verbkinm/IOT/IOTV/docs/Описание протокола IOTV.odt

IOTV протокол, версия 2

# Заголовок протокола

Размер: 24 байта + N байт, N максимум 2⁶⁴ - 1

Версия протокола | Тип пакета | Назначение пакета | Флаги | Номер фрагмента | Количество фрагментов | Размер тела пакета | Контрольная сумма заголовка
1 байт | 1 байт | 1 байт | 1 байта | 2 байта | 2 байта | 8 байт | 8 байт
Тело протокола
(Размер тела пакета) байт

### Версия протокола

Название | Значение
Версия N | N

### Тип пакета

Название | Значение
Отсутствует | 0x00
Запрос | 0x01
Ответ | 0x02

### Назначение пакета

Название | Значение | Должно быть тело протокола
| | Запрос | Ответ
Отсутствует | 0x00 | Нет | Нет
Идентификация устройства | 0x01 | Нет | Да/Нет
Состояние устройства | 0x02 | Да | Да
Чтение данных | 0x03 | Да | Да
Запись данных | 0x04 | Да | Да
Ping/Pong | 0x05 | Нет | Нет
Технические данные | 0x06 | Да | Да
Широковещательное оповещение | 0x07 | Да | Да
Данне лог файла | 0x08 | Да | Да

### Флаги

Название | Значение
Отсутствуют | 0x00
Ошибка | 0xFF

### Размер тела пакета

Количество байт, которое ожидается после заголовка протокола.

### Контрольная сумма заголовка

Необходима для таких способов передачи как UART и пр.

Формула расчёта = Версия протокола + Тип пакета + Назначение пакета + Флаги + Номер фрагмента + Количество фрагментов + Размер тела пакета.

# Тело протокола:

Далее цветом выделена часть пакета, которая может быть фрагментирована.

## Идентификация устройства

Размер: 16 + N байт, N максимум 2⁸ - 1 + 2¹⁶ - 1 + 2⁸ - 1 + 2⁸ - 1 (16 + 66300)

ID устройства | Длина имени устройства | Количество каналов записи | | Количество каналов чтения | Длина описания устройства | | Флаги | Контрольная сумма тела пакета
2 байта | 1 байт | 1 байта | | 1 байт | 2 байта | | 1 байт | 8 байт
Имя устройства
(Длина имени устройства) байт
Тип данных канала записи № N | | | Тип данных канала чтения № N | | | Описание устройства
(Количество каналов записи) байт | | | (Количество каналов чтения) байт | | | (Длина описания устройства) байт

### ID устройства

Список описания устройств по их ID, смотри в файл Список устройств

### Количество каналов

Минимальное значение — 0. Максимальное значение — 255.

### Флаги

Название | Значение
Отсутствуют | 0x00
Удалить устройство | 0x01
Автономное устройство | 0x02
Ошибка | 0xFF

### Контрольная сумма тела пакета

Формула расчета = ID устройства + Длина имени устройства + Длина описания устройства + Количество каналов записи + Количество каналов чтения + Флаги

### Тип данных канала

Типы данных канала описываются размером в один байт. Описание типов каналов смотри в Приложение 1

## Состояние устройства

Размер: 15 + N байт, N максимум 2⁸ - 1 + 2³² - 1 (15 + 255 + 4096 Мб)

Длина имени устройства | Состояние устройства | Флаги | | Размер пакета данных | Контрольная сумма тела пакета
1 байт | 1 байт | 1 байта | | 4 байта | 8 байт
Имя устройства | | | Данные
(Длина имени устройства) байт | | | (Размер пакета данных) байт

На данный момент данные в пакете состояния устройства не задействованы в коде протокола.

### Состояние устройства

Название | Значение
Не доступно | 0x00
Доступно | 0x01

### Флаги

Название | Значение
Отсутствуют | 0x00
Ошибка | 0xFF

### Контрольная сумма тела пакета

### Формула расчёта = Длина имени устройства + Состояние устройства + Флаги + Размер пакета данных

## Чтение / Запись данных

Размер: 15 + N байт, N максимум 2⁸ - 1 + 2³² - 1 (15 + 255 + 4096 Мб)

Длина имени устройства | Номер канала | Флаги | | Размер пакета данных | Контрольная сумма тела пакета
1 байт | 1 байт | 1 байта | | 4 байта | 8 байт
Имя устройства | | | Данные
(Длина имени устройства) байт | | | (Размер пакета данных) байт

### Номер канала

Название | Значение
0 - 255 | 0x00 - 0xFF

### Флаги

Название | Значение
Отсутствуют | 0x00
Игнорировать номер канала (все каналы) | 0x01
Открыть поток | 0x02
Закрыть поток | 0x03
Запись произведена успешно | 0x04
Запись не произведена | 0x05
Ошибка | 0xFF

### Контрольная сумма тела пакета

### Формула расчёта = Длина имени устройства + Номер канала + Флаги + Размер пакета данных

## Технические данные

Размер: 15 + N байт, N максимум 2³² - 1 (15 + 4096 Мб)

Тип | Резерв | Флаги | Размер пакета данных | Контрольная сумма тела пакета
1 байт | 1 байт | 1 байта | 4 байта | 8 байт
Данные
(Размер пакета данных) байт

### Тип

Название | Значение
Отсутствует | 0x00
Передача структуры Событие - Действие (json) (приложение 2) | 0x01
Данные для обновления (json) (приложение 3) | 0x02
Запуск события (json) | 0x03
Запуск действия (json) | 0x04

### Флаги

Название | Значение
Отсутствуют | 0x00
Ошибка | 0xFF

### Контрольная сумма тела пакета

### Формула расчёта = Тип + ~~Резерв~~ + Флаги + Размер пакета данных

## Хост - широковещательное оповещение

Размер: 16 + N байт, N максимум 2⁸ - 1 (16 + 255)

Длина имени устройства | ip4 адрес | Флаги | Порт | Контрольная сумма тела пакета
1 байт | 4 байт | 1 байта | 2 байта | 8 байт
Имя устройства
(Длина имени устройства) байт

### Флаги

Название | Значение
Отсутствуют | 0x00
Клиент использует TCP соединение | 0x01
Клиент использует UDP соединение | 0x02
Ошибка | 0xFF

### Контрольная сумма тела пакета

### Формула расчёта = Длина имени устройства + ip4 адрес + Флаги + Порт

## Данные лог файла хоста

Размер: 35 + N байт, N максимум 2⁸ - 1 + 2³² - 1 (35 + 255 + 4096 Мб)

Для запроса от клиента серверу и для передачи от сервера обработанных данных по фильтрам к клиенту.

Длина имени устройства | Дата/время начала интервала (миллисекунды) | Дата/время конца интервала (миллисекунды) | Интервал между записями (миллисекунды) | Флаги | Номер канала | Размер фрагмента данных
1 байт | 8 байт | 8 байт | 4 байта | 1 байта | 1 байта | 4 байта
Контрольная сумма пакета | | Имя устройства | | Данные
8 байт | | (Длина имени устройства) байт | | (Размер пакета данных) байт

### Флаги

Название | Значение
Для записей R и W в лог файле | 0x00
Для записей R в лог файле | 0x01
Для записей W в лог файле | 0x02
Ошибка | 0xFF

### Контрольная сумма тела пакета

### Формула расчёта = Длина имени устройства + Дата/время начала интервала + Дата/время конца интервала + Флаги + Номер канала + Размер пакета данных.

Структура фрагмента Данные состоит из текстовых строк формата

std::to_string(ms) + " " + valueStr + "\n";

# Приложение 1

### Типы данных каналов

# enum DATA_TYPE

{

INT_8,

INT_16,

INT_32,

INT_64,

FLOAT_32,

DOUBLE_64, // на МК double 32-битный может быть

BOOL,

STRING,

RAW,

NONE

};

# Приложение 2

# Приложение 3

Технические данные. Пример данных пакета:

{

"firmware": {

"version": "1.0",

"url": "https://iotv.verbkinm.ru/ota/firmware.bin"

}

}
