verbkinm/IOT/IOTV/docs/Список устройств.odt

# Типы данных

enum DATA_TYPE

{

DATA_TYPE_INT_8 = 0,

DATA_TYPE_INT_16,

DATA_TYPE_INT_32,

DATA_TYPE_INT_64,

DATA_TYPE_FLOAT_32,

DATA_TYPE_DOUBLE_64, // на МК double может быть 32-битный

DATA_TYPE_BOOL,

DATA_TYPE_STRING,

DATA_TYPE_RAW,

DATA_TYPE_NONE

};

# ID 1 (Switch)

Каналы чтения/записи = от 1 до 255 / от 1 до 255

Тип данных R0 - R255 = DATA_TYPE_BOOL

Тип данных W0 - W255 = DATA_TYPE_BOOL

Значение R0 - R255 = true / false – ON / OFF

Описание устройства: Выключатель.

# ID 2 (Weather station on bme280, DHT22)

Описание: Датчики «погоды» на bme280 или DHT22, или других.

№ | Канал чтения | Канал записи | Тип данных | Диапазоны полезных значений | Описание
Показания датчиков
| + | - | DATA_TYPE_FLOAT_32 | -40 – 85 | Температура в C°.
| + | - | DATA_TYPE_FLOAT_32 | 0 – 100 | Влажность в %.
| + | - | DATA_TYPE_FLOAT_32 | 300 – 1100 | Давление в Pa - hPa.
| + | - | DATA_TYPE_INT_8 | | Заряд аккумулятора.

# ID 3 (File)

Каналы чтения/записи = 1 / 1

Тип данных R0 = DATA_TYPE_STRING

Тип данных W0 = DATA_TYPE_STRING

Описание: Текстовый файл.

# ID 4 (Облачко =))

Описание: Музыкальный ночник.

№ | Канал чтения | Канал записи | Тип данных | Диапазоны полезных значений (по умолчанию) | Описание
| + | + | DATA_TYPE_BOOL | false — true | Выключить / включить воспроизведение. Воспроизводится/не воспроизводится.
| + | + | DATA_TYPE_INT_8 | 1 — 3 (1) | Режим воспроизведения. 1 — колыбельные, 2 — звуки природы, 3 — детские песни.
| + | + | DATA_TYPE_INT_8 | 0 — 6 (0) | Режимы света. 0 — выкл. С 1 и далее — номер режима.
| + | + | DATA_TYPE_BOOL | false — true (false) | Выключить / включить повтор текущего режима воспроизведения.
| + | + | DATA_TYPE_INT_16 | 0 — 8192 (8192) | Максимальная яркость светодиодов.
| + | + | DATA_TYPE_INT_16 | 0 — 8192 (100) | Минимальная яркость светодиодов.
| + | + | DATA_TYPE_INT_8 | 0 — 30 (20) | Громкость.
| + | + | DATA_TYPE_INT_8 | 0x00 — 0x46 (-1) | Цвет светодиода — ручной режим. Старший полубайт — номер светодиода (0 — 4) Младший полубайт — номер цвета (0 — 7)
| + | + | DATA_TYPE_INT_8 | 0 — 5 (0) | Эквалайзер.

# ID 5 (Выключатель расширенный)

Описание: Бесконтактный выключатель с датчиками температуры, влажности. SNTP клиент для синхронизации времени. Данные выводятся на OLED дисплей

№ | Канал чтения | Канал записи | Тип данных | Диапазоны полезных значений | Описание
| + | + | DATA_TYPE_BOOL | вкл./выкл. | состояние реле
| + | + | DATA_TYPE_INT_16 | 0 – 255 | порог срабатывания реле в мм. < установленного значения
Дисплей
| + | + | DATA_TYPE_INT_8 | 0 — 3 | Поворот дисплея: 0 — 0 градусов 1 — 90 градусов 2 — 180 градусов 3 — 270 градусов
Показания датчиков
| + | - | DATA_TYPE_INT_16 | 0 – 255 | текущее расстояние в мм.
| + | - | DATA_TYPE_FLOAT_32 | 1 – 1000 | уровень освещённости в Lux.
| + | - | DATA_TYPE_FLOAT_32 | -40 – 85 | температура в C°.
| + | - | DATA_TYPE_FLOAT_32 | 0 – 100 | влажность в %.
| + | - | DATA_TYPE_FLOAT_32 | 300 – 1100 | давление в Pa - hPa.

# ID 6 (Импульсный счётчик)

Описание:

№ | Канал чтения | Канал записи | Тип данных | Диапазоны полезных значений | Описание
| + | + | DATA_TYPE_INT_64 | 0-... | Количество импульсов 0 канала
| + | + | DATA_TYPE_INT_64 | 0-... | Количество импульсов 1 канала
| + | + | DATA_TYPE_INT_16 | 1-... | Множитель количества импульсов 0 канала
| + | + | DATA_TYPE_INT_16 | 1-... | Множитель количества импульсов 1 канала
| + | + | DATA_TYPE_STRING | строка | Описания канала 0 для вывода на дисплей
| + | + | DATA_TYPE_STRING | строка | Описания канала 1 для вывода на дисплей
| + | + | DATA_TYPE_INT_16 | 0 - 59 | секунды
| + | + | DATA_TYPE_INT_16 | 0 - 59 | минуты
| + | + | DATA_TYPE_INT_16 | 0 - 23 | часы
| + | + | DATA_TYPE_INT_16 | 1 - 7 | день недели
| + | + | DATA_TYPE_INT_16 | 1 - 31 | день месяца
| + | + | DATA_TYPE_INT_16 | 1 - 12 | месяц
| + | + | DATA_TYPE_INT_16 | 0 - 99 | год
1 | + | - | DATA_TYPE_INT_16 | 0 - 4095 | ADC батарейки резервного питания

https://sledi-za-soboy.ru/arduino-rezervnoye-pitaniye-ot-batareyki-d/

# ID 7 (Контроллер RGB Led)

Описание: контроллер управления для rgb лент.

№ | Канал чтения | Канал записи | Тип данных | Диапазоны полезных значений | Описание
1 | + | + | DATA_TYPE_INT_16 | 0 — 255 | Значение красного канала
| + | + | DATA_TYPE_INT_16 | 0 — 255 | Значение зелёного канала
| + | + | DATA_TYPE_INT_16 | 0 — 255 | Значение синего канала
| + | + | DATA_TYPE_INT_16 | 0 — 255 | Общая яркость
| + | + | DATA_TYPE_INT_16 | 0 — n | Световой режим

# ID 8 (Камера)

Описание: камера.

№ | Канал чтения | Канал записи | Тип данных | Диапазоны полезных значений | Описание
1 | + | - | DATA_TYPE_RAW | 0 — 2^32 | Камера — сырые данные
| + | - | DATA_TYPE_RAW | 0 — 2^32 | Микрофон 0 — сырые данные
| + | + | DATA_TYPE_INT_16 | | Камера — ширина
| + | + | DATA_TYPE_INT_16 | | Камера — высота
| + | + | DATA_TYPE_INT_8 | 0 — 100 | Камера — качество

# ID 9 Home_Meteo_II

Описание: время/Дата, локальные температура, влажность и давление. Прогноз погоды для выбранного города. Подключается к wifi сети для синхронизации времени и получения данных о погоде. К данному устройству может подключатся автономные устройства ID2 для передачи удалённых данных температуры, влажности и давление, к примеру, с улицы. Возможно управление устройством по протоколу IOTVP.

№ | Канал чтения | Канал записи | Тип данных | Диапазоны полезных значений | Описание
Локальный датчик ТВД
| + | - | DATA_TYPE_FLOAT_32 | -40 - 80 | Температура в C°
| + | - | DATA_TYPE_FLOAT_32 | 0 - 100 | Влажность в %
| + | - | DATA_TYPE_FLOAT_32 | 300 – 1100 | Давление в Pa - hPa
Внешний датчик ТВД 0
| + | - | DATA_TYPE_FLOAT_32 | -40 - 80 | Температура в C°
| + | - | DATA_TYPE_FLOAT_32 | 0 - 100 | Влажность в %
| + | - | DATA_TYPE_FLOAT_32 | 300 – 1100 | Давление в Pa - hPa
| + | - | DATA_TYPE_FLOAT_32 | 0 - 100 | % батарейки питания
| + | - | DATA_TYPE_INT_64 | time_t | Время получения последних данных c датчика
Внешний датчик ТВД 1
| + | - | DATA_TYPE_FLOAT_32 | -40 - 80 | Температура в C°
| + | - | DATA_TYPE_FLOAT_32 | 0 - 100 | Влажность в %
| + | - | DATA_TYPE_FLOAT_32 | 300 – 1100 | Давление в Pa - hPa
| + | - | DATA_TYPE_INT_64 | time_t | Время получения последних данных c датчика
| + | - | DATA_TYPE_FLOAT_32 | 0 - 100 | % батарейки питания
Время / Дата
| + | + | DATA_TYPE_INT_64 | time_t | Дата/время на устройстве
Wi-Fi станция
| - | + | DATA_TYPE_BOOL | 0 - 1 | Выкл/Вкл. станцию wifi. 0 - Выключено
| + | + | DATA_TYPE_STRING | | Имя wifi точки
| + | + | DATA_TYPE_STRING | | Пароль от wifi точки
| + | + | DATA_TYPE_BOOL | 0 - 1 | Выкл./Вкл. автоподключение
| + | - | DATA_TYPE_STRING | | Дополнительные данные
Дисплей
| + | + | DATA_TYPE_INT_8 | 0 - 1 | Поворот дисплея на 180 градусов
| + | + | DATA_TYPE_INT_16 | 0 - 255 | Яркость дисплея
| + | + | DATA_TYPE_BOOL | 0 - 1 | Выкл/Вкл. ночной режим
| + | + | DATA_TYPE_INT_16 | 0 - 255 | Яркость днём при включенном ночном режиме
| + | + | DATA_TYPE_INT_16 | 0 - 255 | Яркость ночью при включенном ночном режиме
| + | + | DATA_TYPE_STRING | "dd:dd:dd" | Время начала дневного интервала
| + | + | DATA_TYPE_STRING | "dd:dd:dd" | Время начала ночного интервала
SNTP
| + | + | DATA_TYPE_BOOL | 0 - 1 | Выкл./Вкл.
| + | + | DATA_TYPE_STRING | "UTC-5" | UTC от 0, пример: "UTC-2" — МСК часовой пояс
| + | + | DATA_TYPE_STRING | "pool.ntp.org" | Url сервера времени
Update
| + | + | DATA_TYPE_BOOL | 0 - 1 | Выкл./Вкл.
| + | + | DATA_TYPE_INT_64 | 0 - ... | Интервал проверки обновлений в секундах
| + | + | DATA_TYPE_STRING | "https://ota.verbkinm.ru/other/esp32/meteo_home_II/update_info.json" | Url json файла с информацией об обновлении
| + | - | DATA_TYPE_STRING | "0.0.1" | Версия прошивки устройства
| + | - | DATA_TYPE_STRING | "0.0" | Доступная версия прошивки
Метео
| + | + | DATA_TYPE_BOOL | 0 - 1 | Выкл./Вкл.
| + | - | DATA_TYPE_STRING | "Югорск" | Наименование города
| + | - | DATA_TYPE_FLOAT_32 | 61.312260 | широта
| + | - | DATA_TYPE_FLOAT_32 | 63.330669 | долгота
IOTV сервер
| + | + | DATA_TYPE_STRING | "iotv.verbkinm.ru" | Hostname
| + | + | DATA_TYPE_INT_64 | 0 - 65535 | Tcp порт
SD
| + | - | DATA_TYPE_STRING | | Дополнительные данные
Дополнительные параметры / действия
| + | + | DATA_TYPE_INT_8 | 0 - n | Текущая страница
| - | + | DATA_TYPE_BOOL | 0 - 1 | Перезагрузить устройство
| - | + | DATA_TYPE_BOOL | 0 - 1 | Обновить данные sntp
| - | + | DATA_TYPE_BOOL | 0 - 1 | Обновить данные метео
| - | + | DATA_TYPE_BOOL | 0 - 1 | Проверить наличие обновлений
