verbkinm/IOT/IOTV/docs/Схемы и документация на устройства/ESP/ESP32-S3-Wroom-1.webp

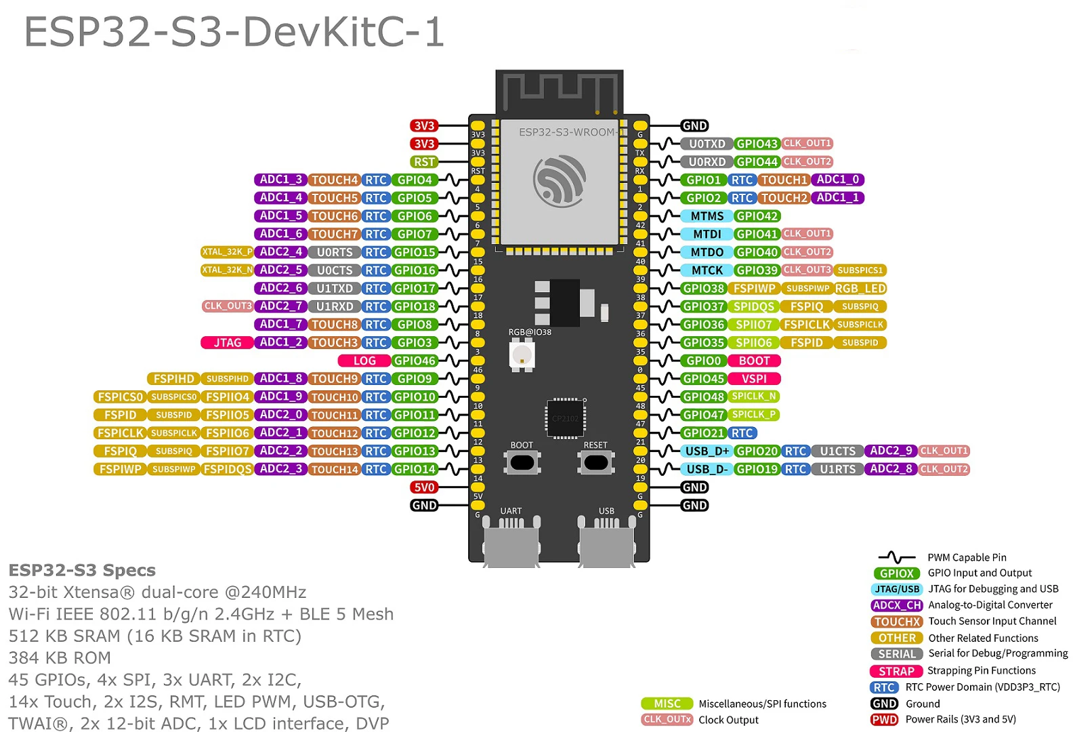
IOTV/docs/Схемы и документация на устройства/ESP/ESP32-S3-Wroom-1.webp
