verbkinm/IOT/IOTV/docs/Схемы и документация на устройства/ESP/ESP8266-12E-Wemos-D1-Mini-pinout.webp

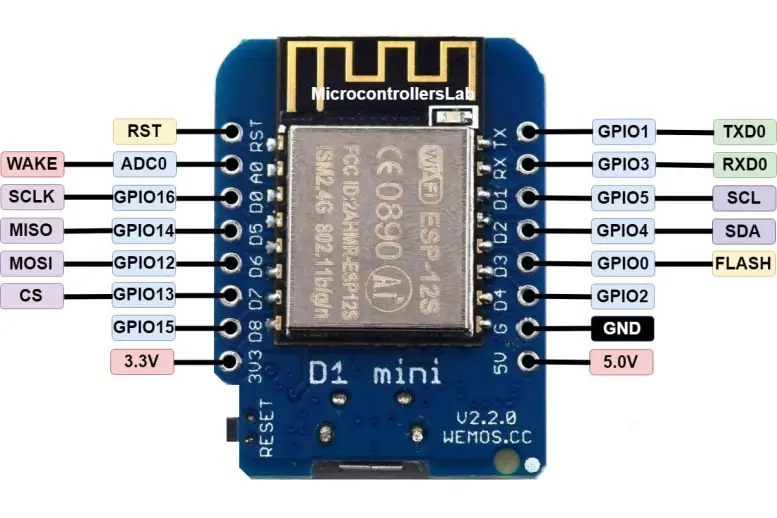
IOTV/docs/Схемы и документация на устройства/ESP/ESP8266-12E-Wemos-D1-Mini-pinout.webp
