verbkinm/IOT/IOTV/docs/Схемы и документация на устройства/ESP/esp8266-pinout.jpeg

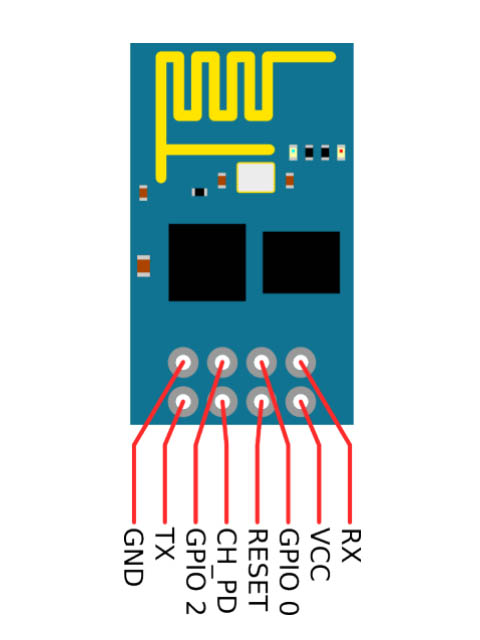
IOTV/docs/Схемы и документация на устройства/ESP/esp8266-pinout.jpeg
