verbkinm/IOT/IOTV/docs/Схемы и документация на устройства/ESP/ESP-01_Connection.png

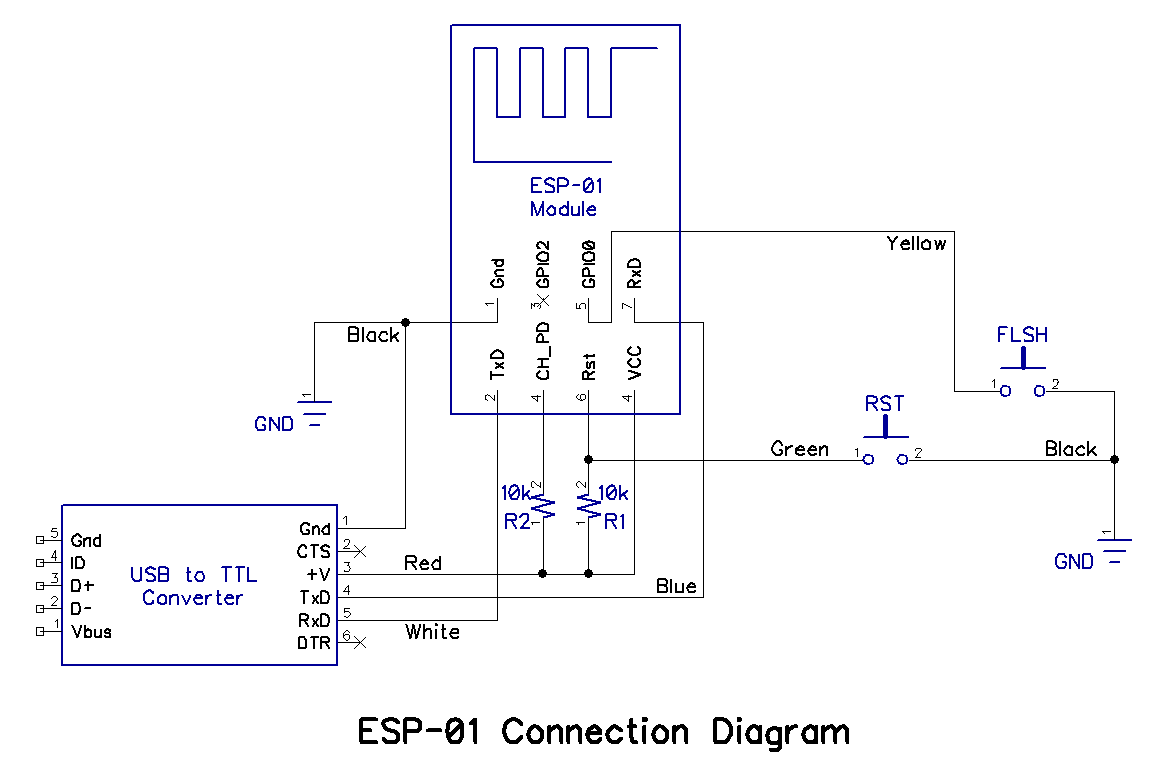
IOTV/docs/Схемы и документация на устройства/ESP/ESP-01_Connection.png
