verbkinm/IOT/IOTV/docs/Схемы и документация на устройства/ESP/загруженное.png

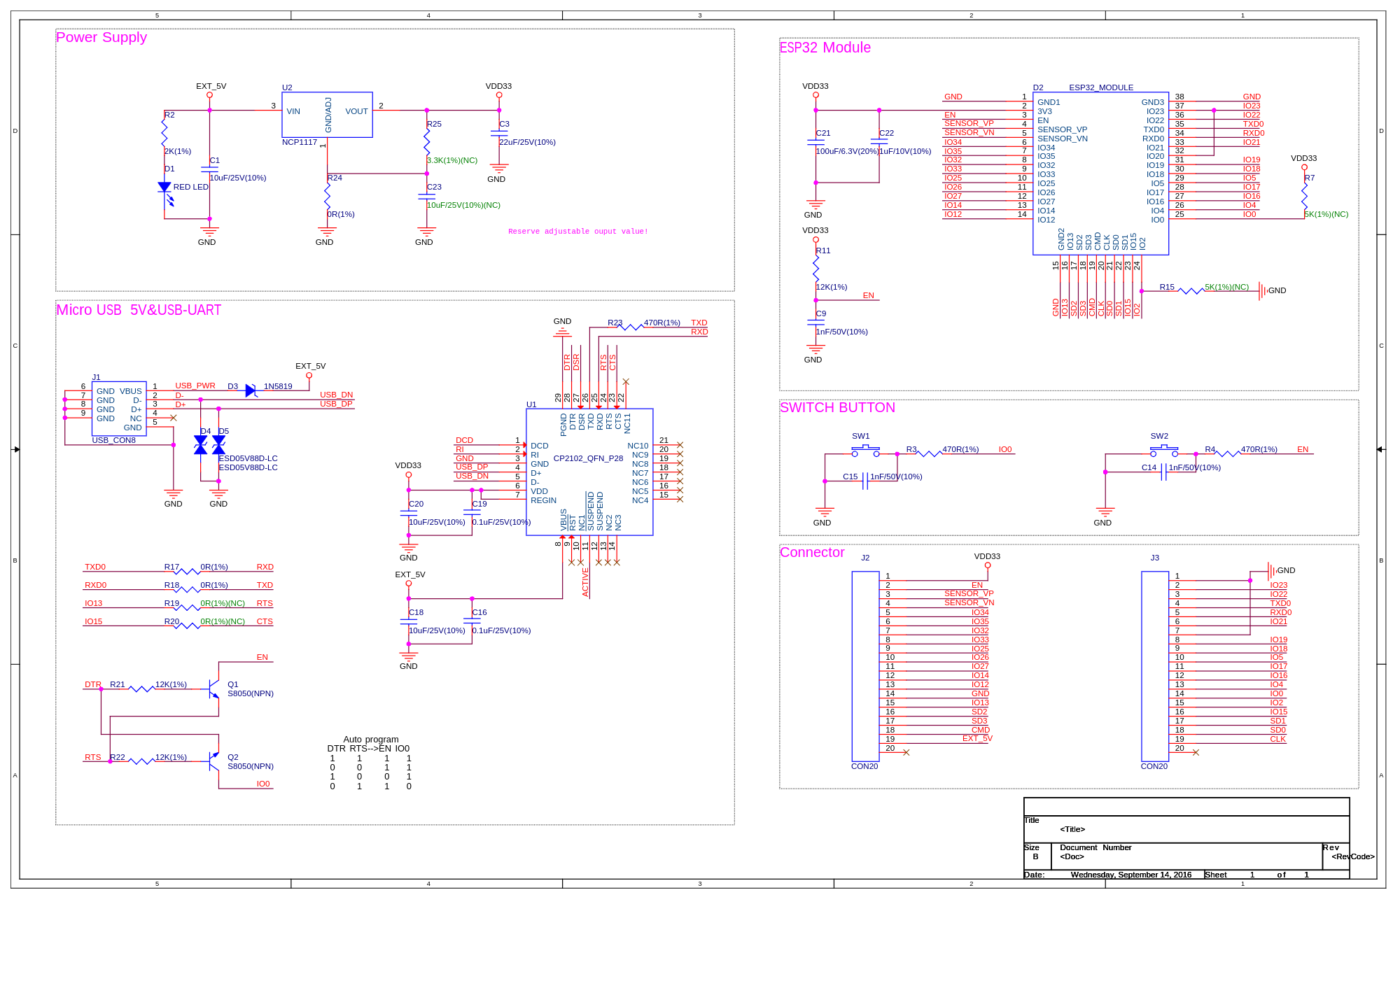
IOTV/docs/Схемы и документация на устройства/ESP/загруженное.png
