verbkinm/IOT/IOTV/docs/Схемы и документация на устройства/Ардуино/arduino pro mini.png

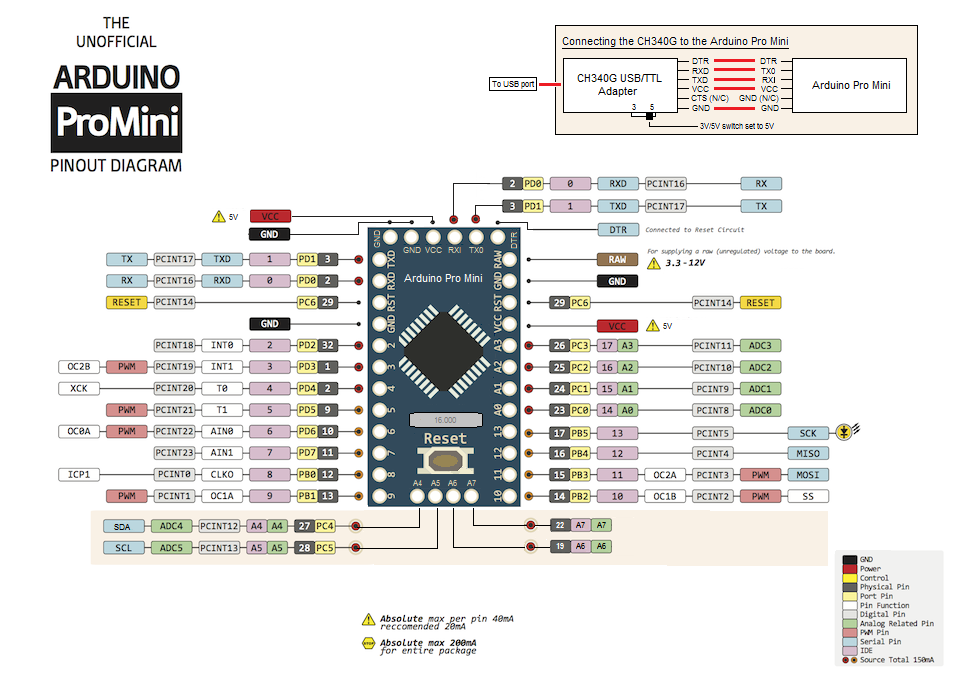
IOTV/docs/Схемы и документация на устройства/Ардуино/arduino pro mini.png
