verbkinm/IOT/IOTV/src/IOTV_Client_QML/img/actions/data_tx.png

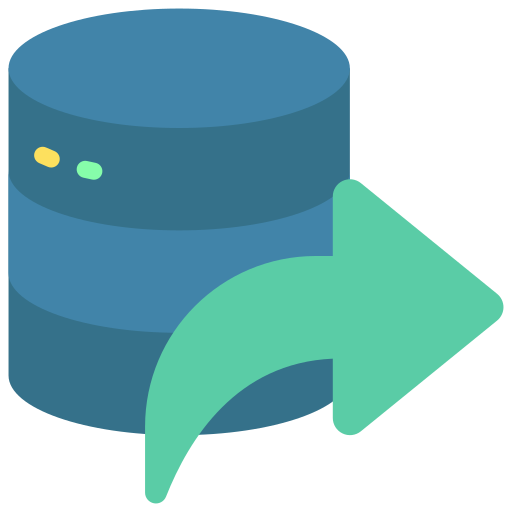
IOTV/src/IOTV_Client_QML/img/actions/data_tx.png
