verbkinm/IOT/IOTV/src/IOTV_Client_QML/img/actions/data_tx_ref.png

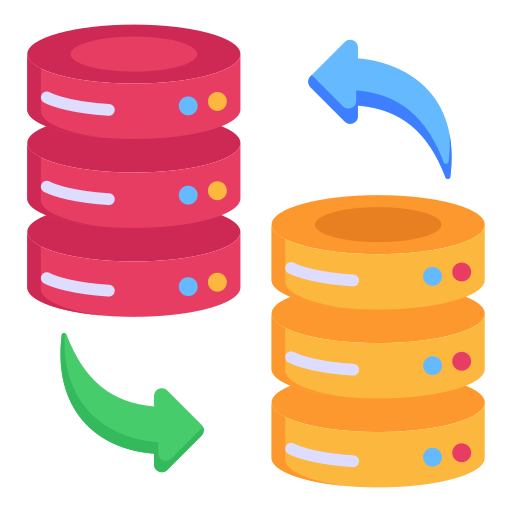
IOTV/src/IOTV_Client_QML/img/actions/data_tx_ref.png
