verbkinm/IOT/IOTV/src/IOTV_Client_QML/img/back.png

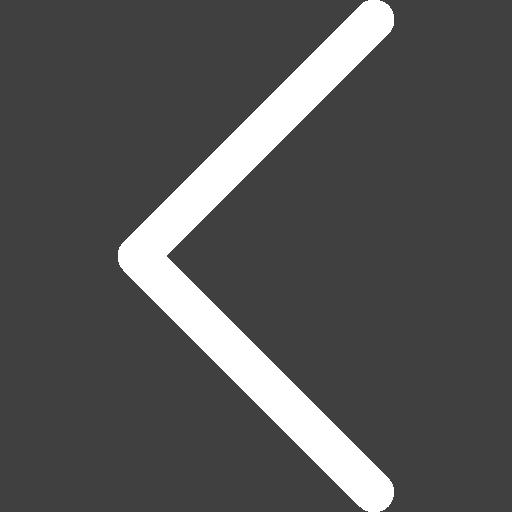
IOTV/src/IOTV_Client_QML/img/back.png
