verbkinm/IOT/IOTV/src/IOTV_Client_QML/img/calendar_white.png

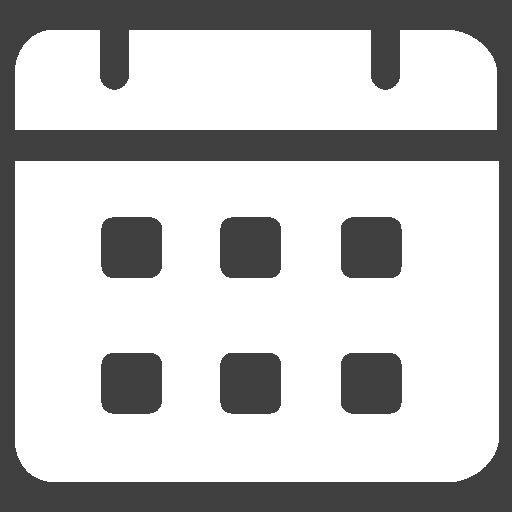
IOTV/src/IOTV_Client_QML/img/calendar_white.png
