verbkinm/IOT/IOTV/src/IOTV_Client_QML/img/copy_white.png

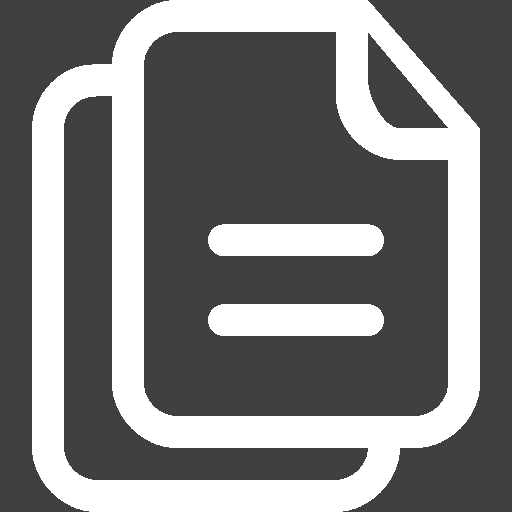
IOTV/src/IOTV_Client_QML/img/copy_white.png
