verbkinm/IOT/IOTV/src/IOTV_Client_QML/img/delete_white.png

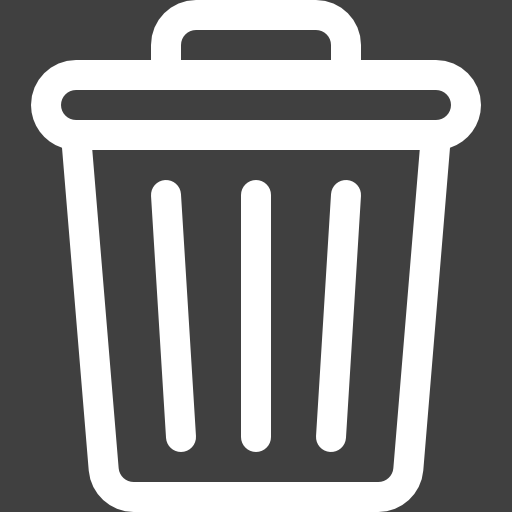
IOTV/src/IOTV_Client_QML/img/delete_white.png
