verbkinm/IOT/IOTV/src/IOTV_Client_QML/img/edit_white.png

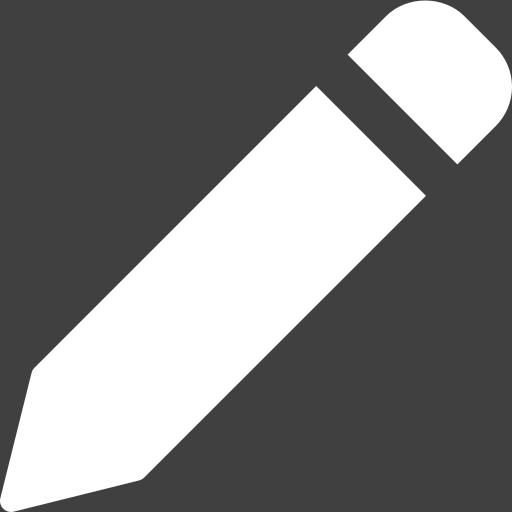
IOTV/src/IOTV_Client_QML/img/edit_white.png
