verbkinm/IOT/IOTV/src/IOTV_Client_QML/img/events.png

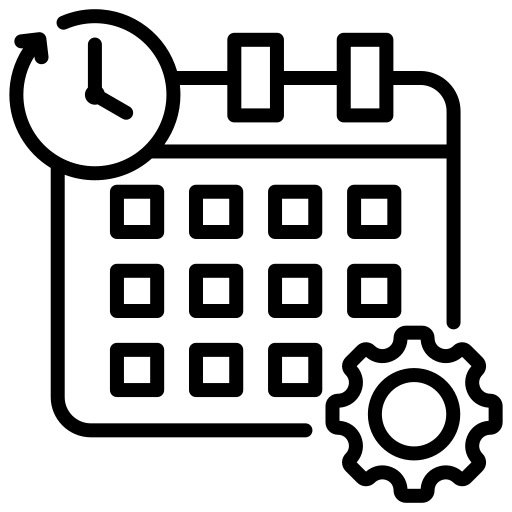
IOTV/src/IOTV_Client_QML/img/events.png
