verbkinm/IOT/IOTV/src/IOTV_Client_QML/img/events/alarm.png

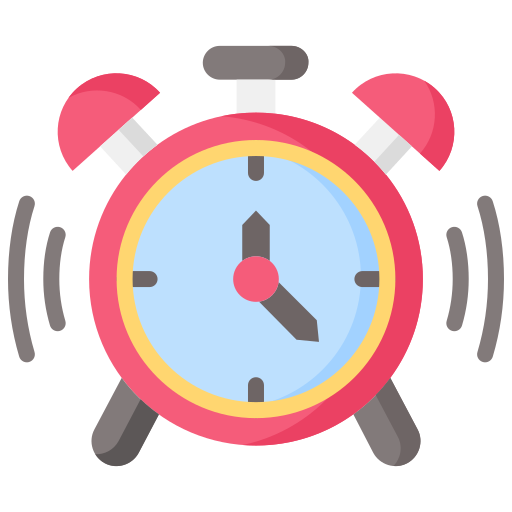
IOTV/src/IOTV_Client_QML/img/events/alarm.png
