verbkinm/IOT/IOTV/src/IOTV_Client_QML/img/events/connected.png

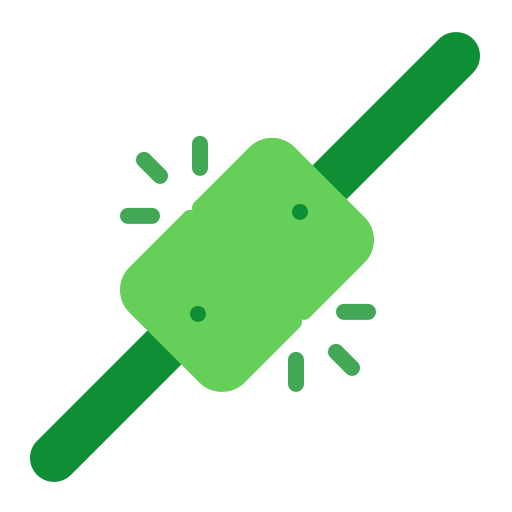
IOTV/src/IOTV_Client_QML/img/events/connected.png
