verbkinm/IOT/IOTV/src/IOTV_Client_QML/img/events/disconnected.png

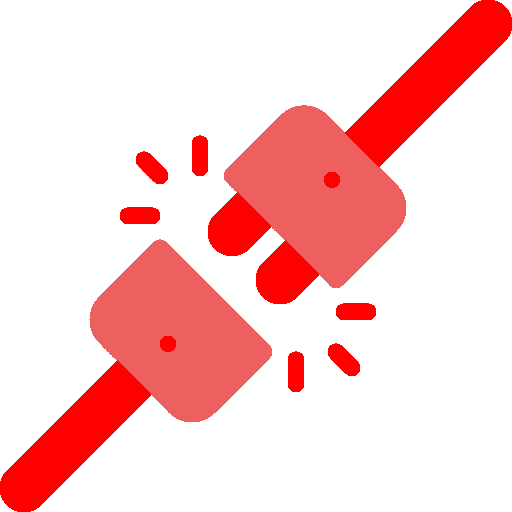
IOTV/src/IOTV_Client_QML/img/events/disconnected.png
