verbkinm/IOT/IOTV/src/IOTV_Client_QML/img/folder_actions.png

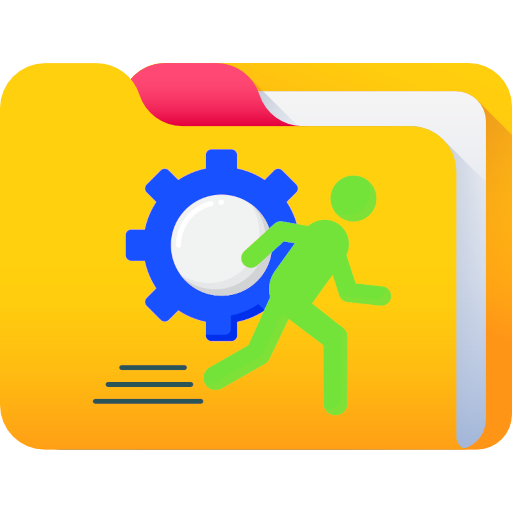
IOTV/src/IOTV_Client_QML/img/folder_actions.png
