verbkinm/IOT/IOTV/src/IOTV_Client_QML/img/folder_events.png

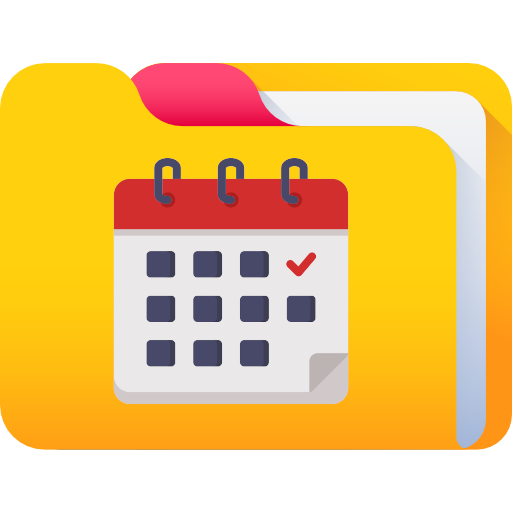
IOTV/src/IOTV_Client_QML/img/folder_events.png
