verbkinm/IOT/IOTV/src/IOTV_Client_QML/img/forward.png

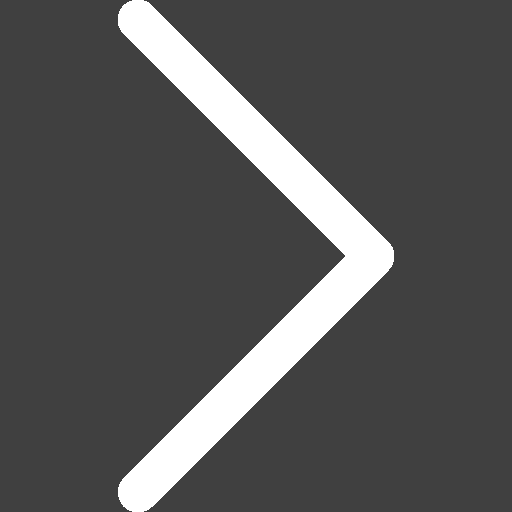
IOTV/src/IOTV_Client_QML/img/forward.png
