verbkinm/IOT/IOTV/src/IOTV_Client_QML/img/home.png

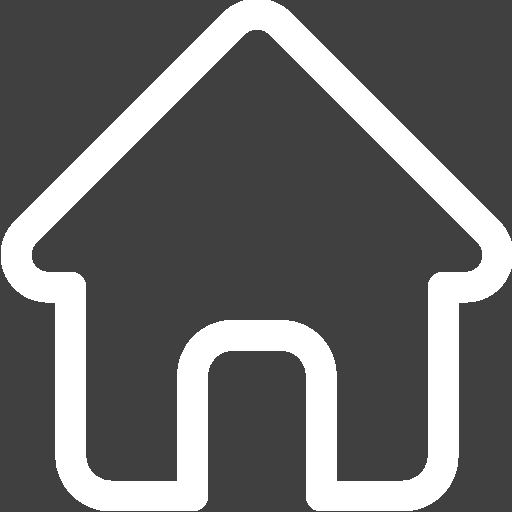
IOTV/src/IOTV_Client_QML/img/home.png
