verbkinm/IOT/IOTV/src/IOTV_Client_QML/img/id/0.png

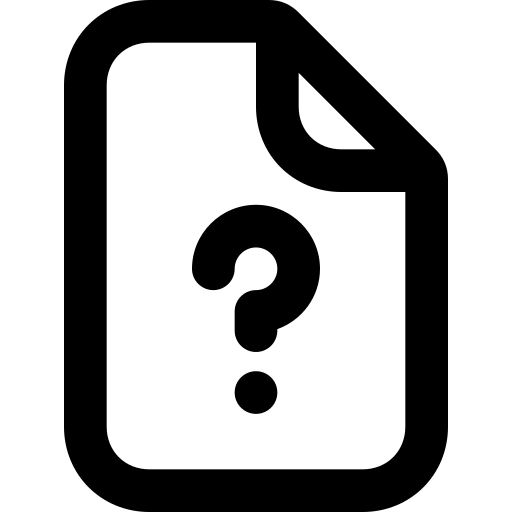
IOTV/src/IOTV_Client_QML/img/id/0.png
