verbkinm/IOT/IOTV/src/IOTV_Client_QML/img/id_4/cloud_off.png

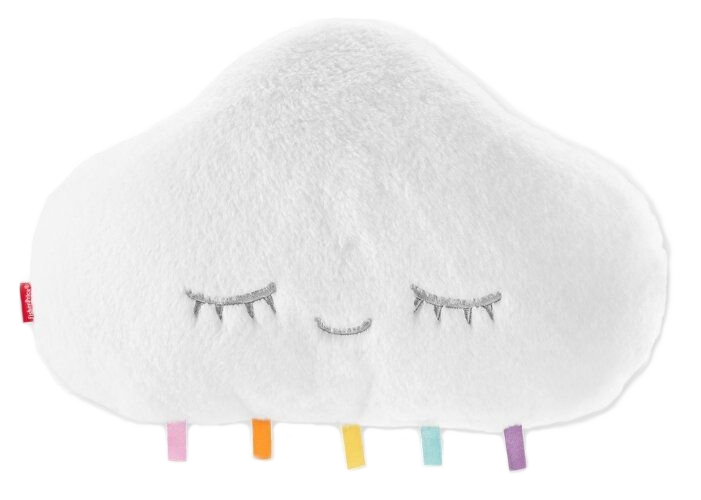
IOTV/src/IOTV_Client_QML/img/id_4/cloud_off.png
