verbkinm/IOT/IOTV/src/IOTV_Client_QML/img/id_4/lamp_off.png

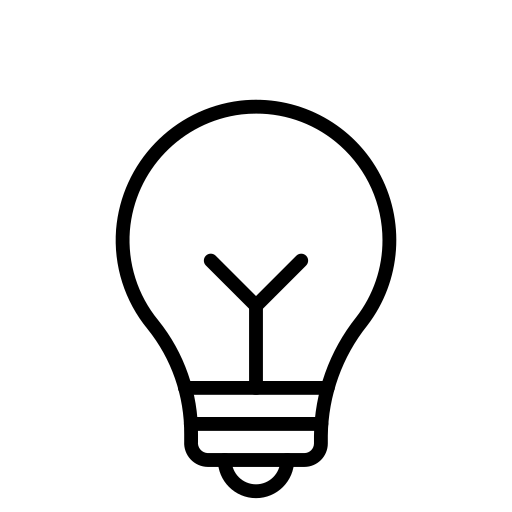
IOTV/src/IOTV_Client_QML/img/id_4/lamp_off.png
