verbkinm/IOT/IOTV/src/IOTV_Client_QML/img/id_4/lamp_off_white.png

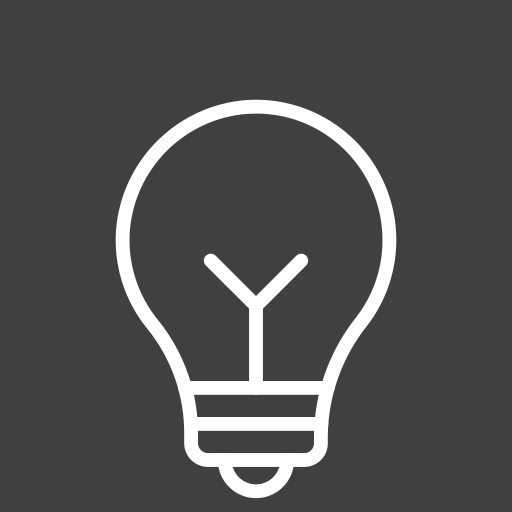
IOTV/src/IOTV_Client_QML/img/id_4/lamp_off_white.png
