verbkinm/IOT/IOTV/src/IOTV_Client_QML/img/id_4/palette_white.png

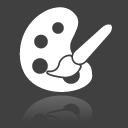
IOTV/src/IOTV_Client_QML/img/id_4/palette_white.png
