verbkinm/IOT/IOTV/src/IOTV_Client_QML/img/id_4/toy.png

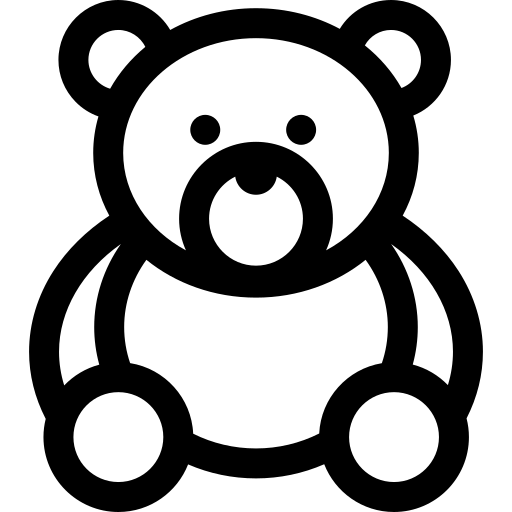
IOTV/src/IOTV_Client_QML/img/id_4/toy.png
