verbkinm/IOT/IOTV/src/IOTV_Client_QML/img/id_4/toy_white.png

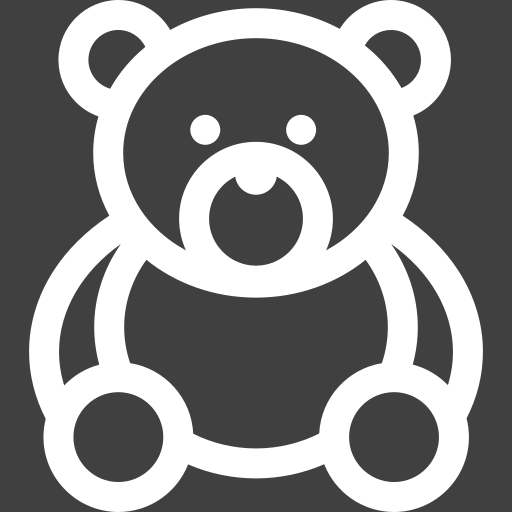
IOTV/src/IOTV_Client_QML/img/id_4/toy_white.png
