verbkinm/IOT/IOTV/src/IOTV_Client_QML/img/id_8/repeate_on_white.png

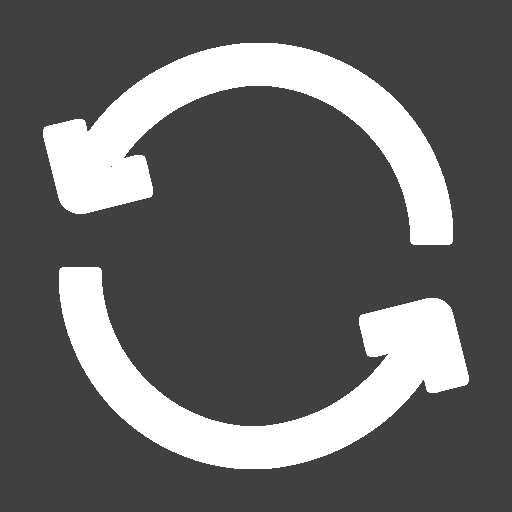
IOTV/src/IOTV_Client_QML/img/id_8/repeate_on_white.png
