verbkinm/IOT/IOTV/src/IOTV_Client_QML/img/id_8/stop.png

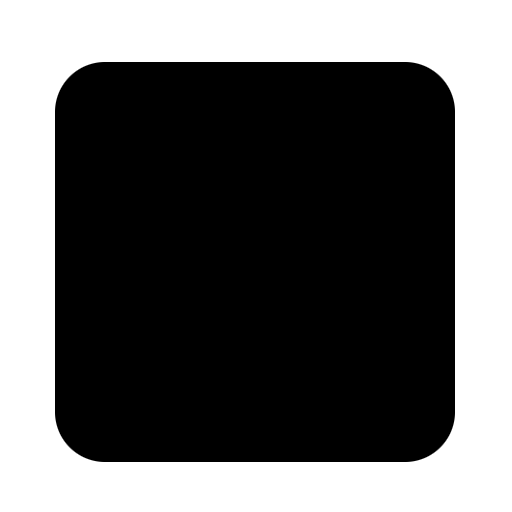
IOTV/src/IOTV_Client_QML/img/id_8/stop.png
