verbkinm/IOT/IOTV/src/IOTV_Client_QML/img/menu.png

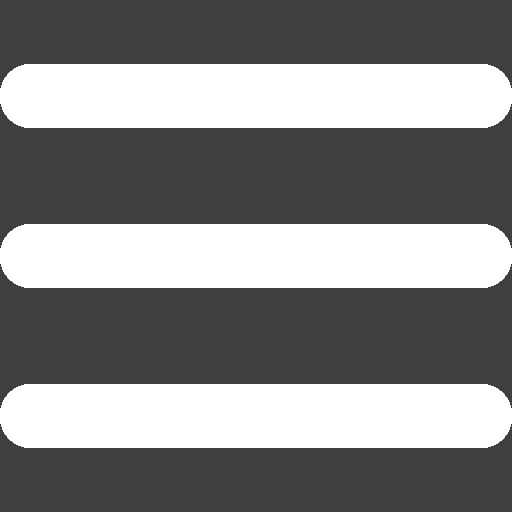
IOTV/src/IOTV_Client_QML/img/menu.png
