verbkinm/IOT/IOTV/src/IOTV_Client_QML/img/question_mark_white.png

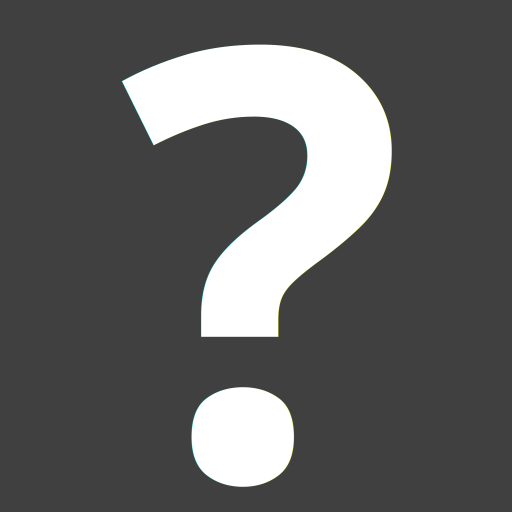
IOTV/src/IOTV_Client_QML/img/question_mark_white.png
