verbkinm/IOT/IOTV/src/IOTV_Client_QML/img/save_white.png

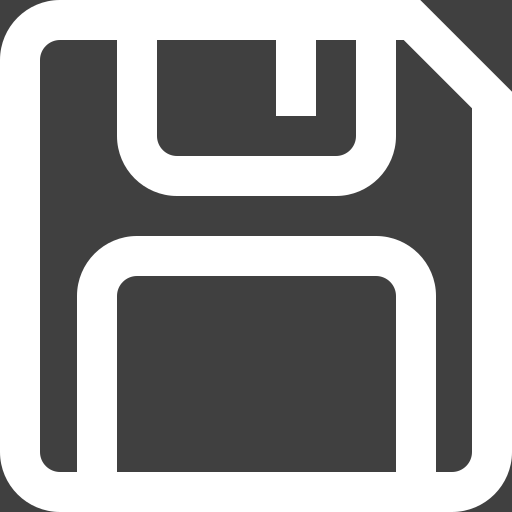
IOTV/src/IOTV_Client_QML/img/save_white.png
