verbkinm/IOT/IOTV/src/IOTV_Client_QML/img/send_white.png

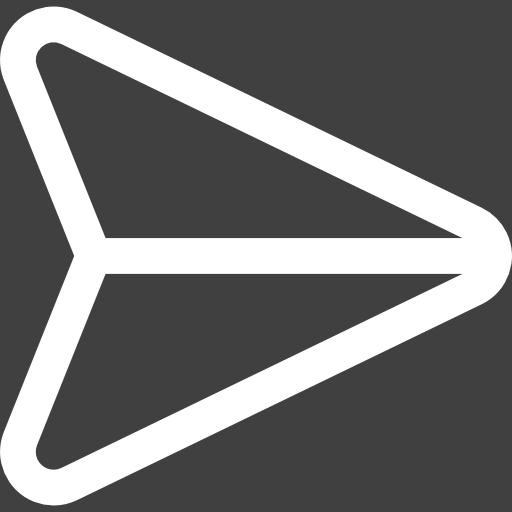
IOTV/src/IOTV_Client_QML/img/send_white.png
