verbkinm/IOT/IOTV/src/IOTV_Client_QML/img/settings_white.png

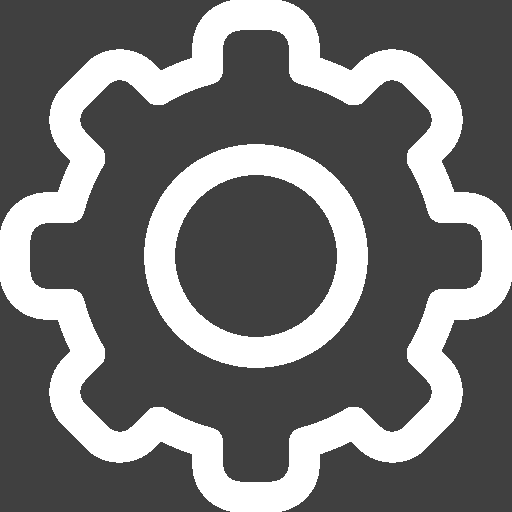
IOTV/src/IOTV_Client_QML/img/settings_white.png
