verbkinm/IOT/IOTV/src/IOTV_Client_QML/img/zoom_white.png

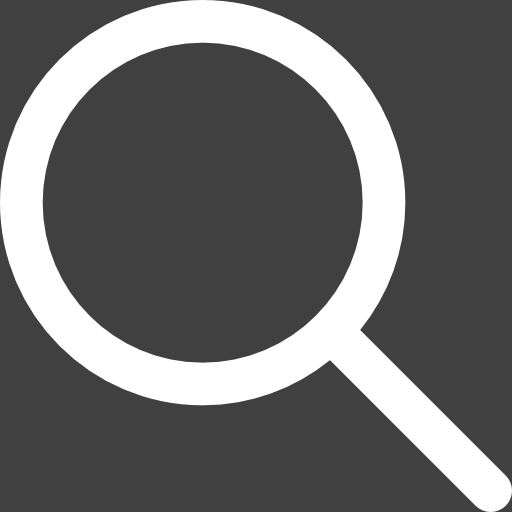
IOTV/src/IOTV_Client_QML/img/zoom_white.png
