verbkinm/IOT/readme_img/screen_6.png

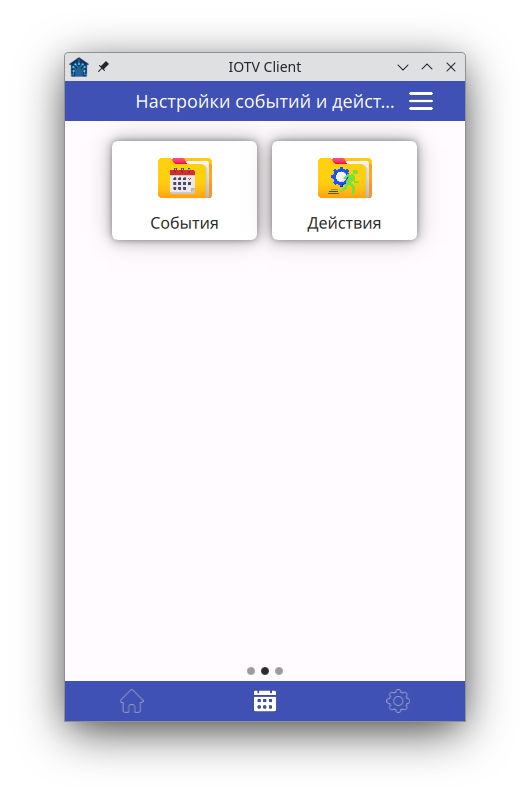
readme_img/screen_6.png
