verbkinm/IOT/readme_img/screen_7.png

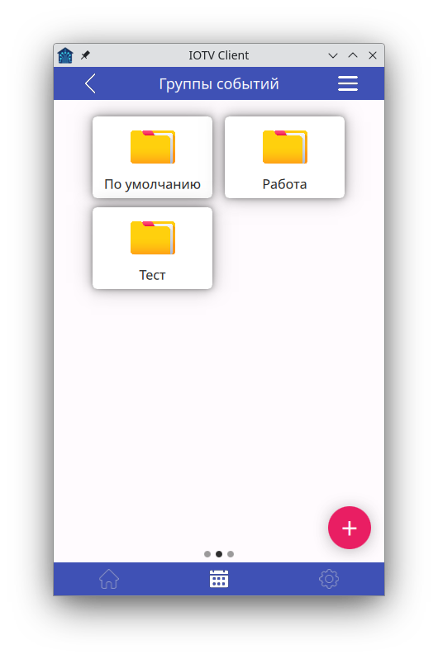
readme_img/screen_7.png
