verbkinm/IOT/readme_img/screen_8.png

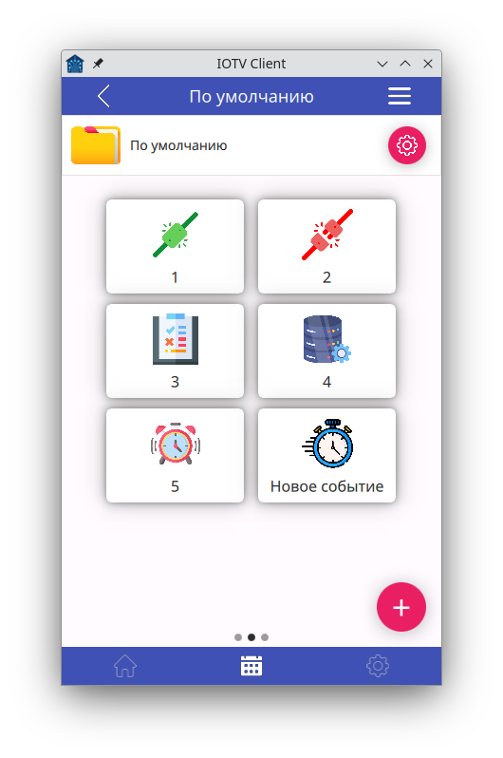
readme_img/screen_8.png
