verbkinm/IOT/readme_img/screen_9.png

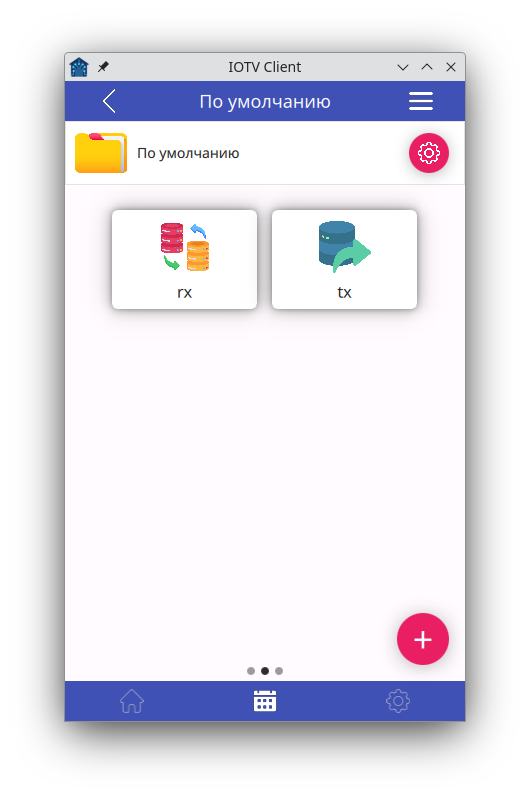
readme_img/screen_9.png
