verbkinm/IOT/IOTV/cad/id4.FCStd

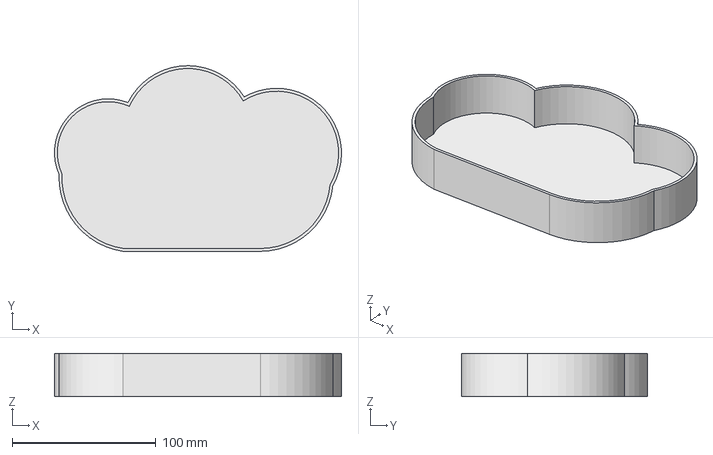
[picture p58: CAD file, 2023-07-27]
IOTV/cad/id4.FCStd
199.8 x 129.3 x 30.0 mm
