verbkinm/IOT/IOTV/cad/id4/id4.1.FCStd

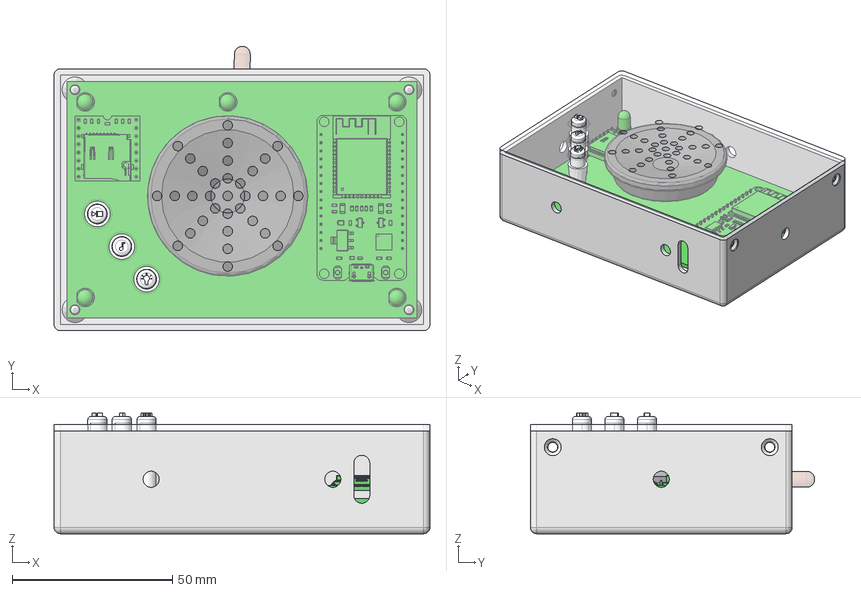
[picture p59: CAD file, 2023-08-03]
IOTV/cad/id4/id4.1.FCStd
117.2 x 88.7 x 37.6 mm
динамик
Плата001
