verbkinm/IOT/IOTV/cad/id5.FCStd

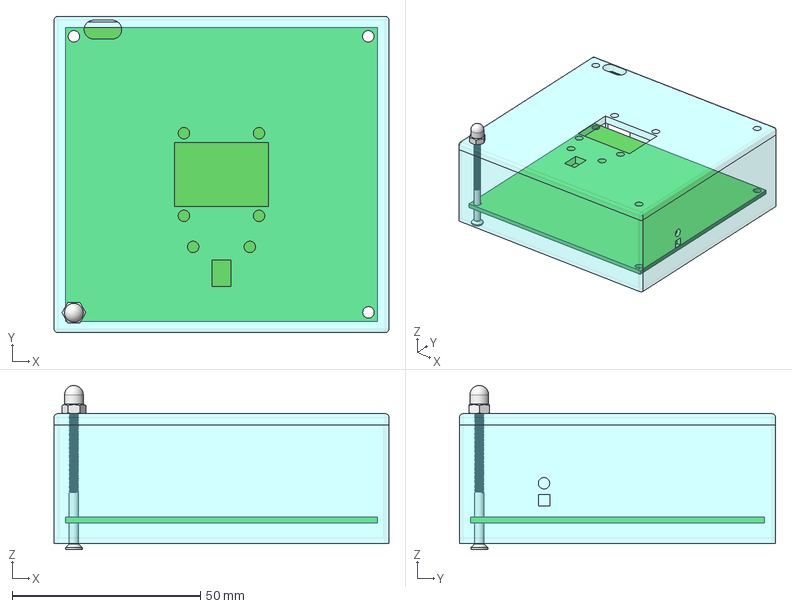
[picture p60: CAD file, 2023-06-13]
IOTV/cad/id5.FCStd
89.0 x 84.0 x 43.6 mm
Плата002
Крышка001
Корпус
M2.5x40-Винт
M3-Гайка
