verbkinm/IOT/IOTV/todo.txt

переделать IOTV_SH, что бы все responce и query разбивали пакеты больших размеров на части,
    во все функции query добавить указатель на функцию записи данных, как это сделано в responce функциях
