verbkinm/IOT/IOTV/src/IOTV_Client_QML/img/debug_white.png

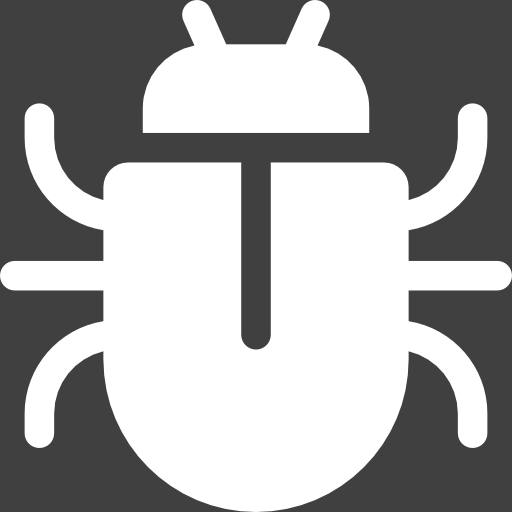
IOTV/src/IOTV_Client_QML/img/debug_white.png
