verbkinm/IOT/IOTV/pcb/IOTV_id4/id4/untitled.kicad_sch

## KiCad design IOTV/pcb/IOTV_id4/id4/untitled.kicad_sch (2023-07-24)

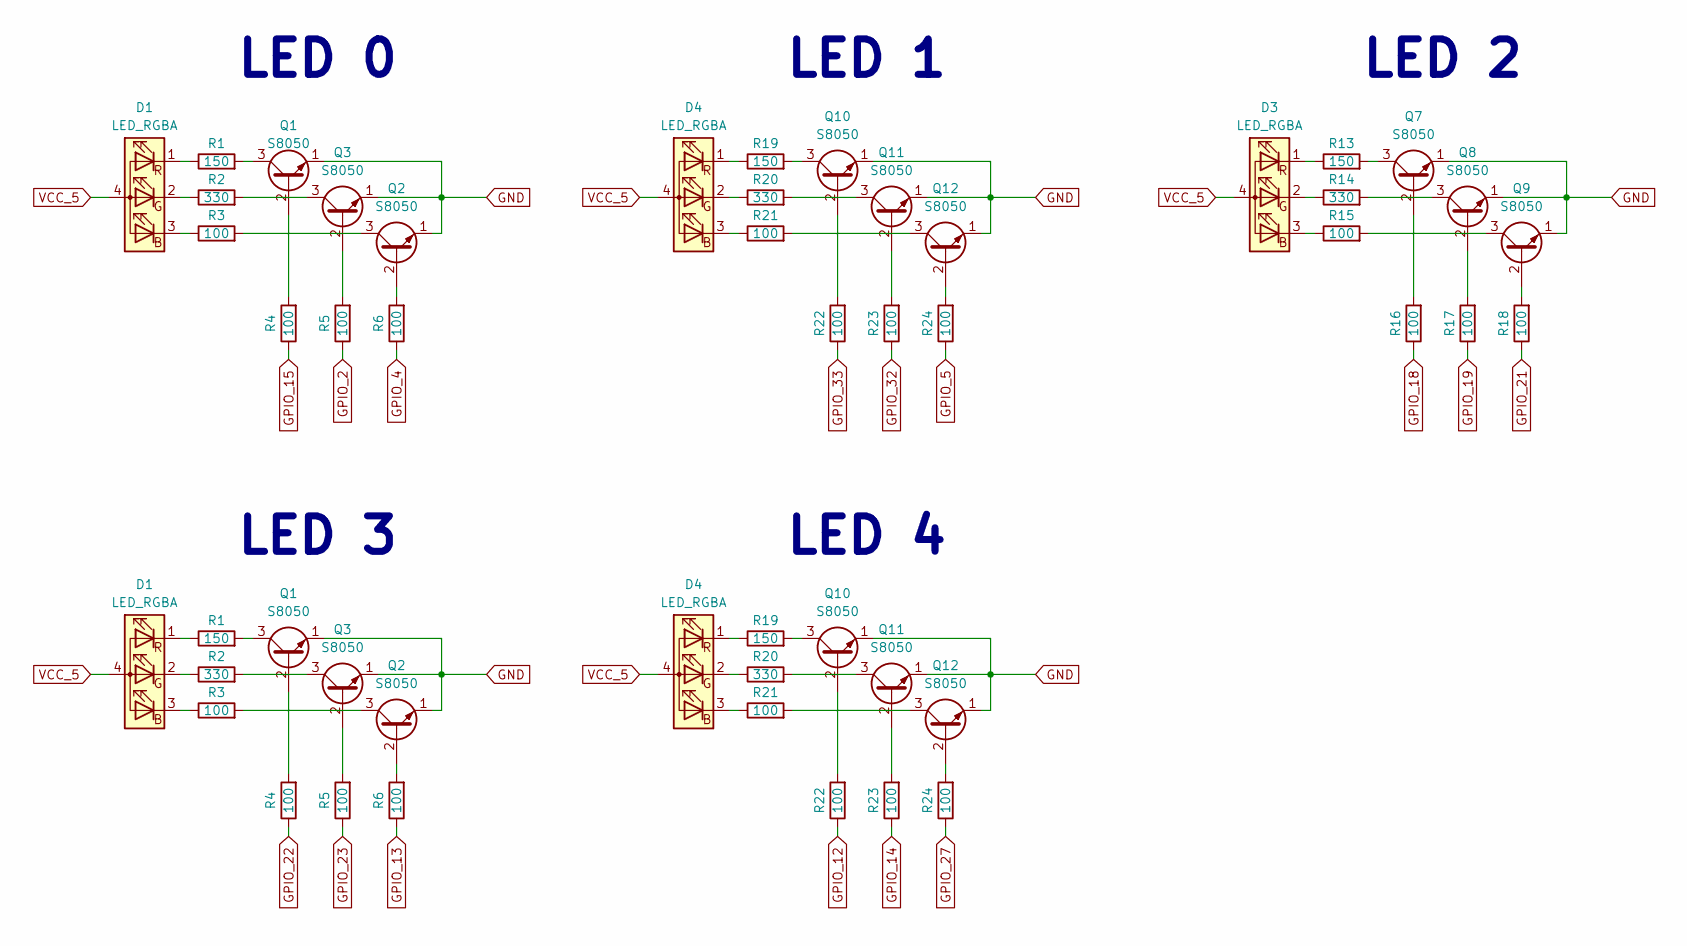
[picture p62: schematic untitled.kicad_sch]

Parts:
D1, D3, D4: LED_RGBA; LED_D5.0mm-4_RGB
Q1, Q2, Q3, Q7, Q8, Q9, Q10, Q11, Q12: S8050; SOT-23
R1, R13, R19: 150; R_1206_3216Metric
R2, R14, R20: 330; R_1206_3216Metric
R3, R4, R5, R6, R15, R16, R17, R18, R21, R22, R23, R24: 100; R_1206_3216Metric

Connections:
GND: Q1.1 (E), Q2.1 (E), Q3.1 (E), Q7.1 (E), Q8.1 (E), Q9.1 (E), Q10.1 (E), Q11.1 (E), Q12.1 (E)
GPIO_2: R5.1
GPIO_4: R6.1
GPIO_5: R24.1
GPIO_12: R22.1
GPIO_13: R6.1
GPIO_14: R23.1
GPIO_15: R4.1
GPIO_18: R16.1
GPIO_19: R17.1
GPIO_21: R18.1
GPIO_22: R4.1
GPIO_23: R5.1
GPIO_27: R24.1
GPIO_32: R23.1
GPIO_33: R22.1
unnamed: D1.1 (RK), R1.1
unnamed: D1.2 (GK), R2.1
unnamed: D1.3 (BK), R3.1
unnamed: D3.1 (RK), R13.1
unnamed: D3.2 (GK), R14.1
unnamed: D3.3 (BK), R15.1
unnamed: D4.1 (RK), R19.1
unnamed: D4.2 (GK), R20.1
unnamed: D4.3 (BK), R21.1
unnamed: Q1.2 (B), R4.2
unnamed: Q1.3 (C), R1.2
unnamed: Q2.2 (B), R6.2
unnamed: Q2.3 (C), R3.2
unnamed: Q3.2 (B), R5.2
unnamed: Q3.3 (C), R2.2
unnamed: Q7.2 (B), R16.2
unnamed: Q7.3 (C), R13.2
unnamed: Q8.2 (B), R17.2
unnamed: Q8.3 (C), R14.2
unnamed: Q9.2 (B), R18.2
unnamed: Q9.3 (C), R15.2
unnamed: Q10.2 (B), R22.2
unnamed: Q10.3 (C), R19.2
unnamed: Q11.2 (B), R23.2
unnamed: Q11.3 (C), R20.2
unnamed: Q12.2 (B), R24.2
unnamed: Q12.3 (C), R21.2
VCC_5: D1.4 (A), D3.4 (A), D4.4 (A)

Notes on the sheet:
LED 0
LED 4
LED 2
LED 3
LED 1
