verbkinm/IOT/IOTV/src/IOTV_HOSTS_PC/UDP/IOTV_host_switch_UDP/main.cpp

#include <QCoreApplication>
#include <QUdpSocket>
#include <QNetworkDatagram>

#include <iostream>

#include "creatorpkgs.h"
#include "IOTV_SH.h"
#include "iotv_server_embedded.h"
#include "iotv_types.h"


QUdpSocket *socket = nullptr;

char recivedBuffer[BUFSIZ], transmitBuffer[BUFSIZ];
uint64_t realBufSize = 0;

uint64_t expextedDataSize = HEADER_SIZE;
uint64_t cutDataSize = 0;
bool error = false;


uint8_t readType[3] = {DATA_TYPE_BOOL, DATA_TYPE_BOOL, DATA_TYPE_BOOL};
uint8_t writeType[3] = {DATA_TYPE_BOOL, DATA_TYPE_BOOL, DATA_TYPE_BOOL};

QByteArray buffer;

iotv_obj_t iot = {
    .id = 1,
    .numberReadChannel = 3,
    .numberWriteChannel = 3,
    .state = 1,
    .nameSize = 10,
    .descriptionSize = 11,

    .readChannel = NULL,
    .readChannelType = readType,
    .writeChannelType = writeType,

    .name = (char *)"Device UDP",
    .description = (char *)"Description",
};

uint64_t writeFunc(char *data, uint64_t size, void *obj)
{
    QNetworkDatagram *datagram = (QNetworkDatagram *)obj;

    if (datagram == nullptr)
        return 0;

    QHostAddress peerHost = datagram->senderAddress();
    quint16 peerPort = datagram->senderPort();

    auto s = socket->writeDatagram(data, size, peerHost, peerPort);
    return s;
}

void slotDataRecived()
{
    QNetworkDatagram datagram = socket->receiveDatagram();
    buffer.append(datagram.data());

    qDebug() << buffer.toHex(':') << '\n';

    if ((uint64_t)buffer.size() < expextedDataSize)
        return;

    while (buffer.size() > 0)
    {
        memcpy(recivedBuffer, buffer.data(), buffer.size());

        header_t* header = createPkgs((uint8_t*)recivedBuffer, buffer.size(), &error, &expextedDataSize, &cutDataSize);

        if (error == true)
        {
            realBufSize = 0;
            expextedDataSize = 0;
            cutDataSize = 0;
            buffer.clear();
            return;
        }

        if (expextedDataSize > 0)
            return;

        if (header->type == HEADER_TYPE_REQUEST)
        {
            QHostAddress peerHost = datagram.senderAddress();
            quint16 peerPort = datagram.senderPort();

            if (header->assignment == HEADER_ASSIGNMENT_IDENTIFICATION)
                responseIdentificationData(transmitBuffer, BUFSIZ, &iot, writeFunc, (void *)socket, Identification_FLAGS_NONE, HEADER_FLAGS_NONE);
            else if (header->assignment == HEADER_ASSIGNMENT_READ)
            {
                responseReadData(transmitBuffer, BUFSIZ, &iot, header, writeFunc, (void *)&datagram, ReadWrite_FLAGS_NONE, HEADER_FLAGS_NONE);
            }
            else if (header->assignment == HEADER_ASSIGNMENT_WRITE)
                responseWriteData(transmitBuffer, BUFSIZ, &iot, header, writeFunc, (void *)socket, ReadWrite_FLAGS_NONE, HEADER_FLAGS_NONE);
            else if (header->assignment == HEADER_ASSIGNMENT_PING_PONG)
            {
                uint64_t size = responsePingData(transmitBuffer, BUFSIZ,  writeFunc, (void *)socket, HEADER_FLAGS_NONE);
                QByteArray data;
                data.append(transmitBuffer, size);
                std::cout << peerHost.toString().toStdString().c_str() << ":" << peerPort << " -> " << data.toHex(':').data() << '\n';
            }
            else if (header->assignment == HEADER_ASSIGNMENT_STATE)
                responseStateData(transmitBuffer, BUFSIZ, &iot, writeFunc, (void *)socket, STATE_FLAGS_NONE, HEADER_FLAGS_NONE);
        }

        buffer = buffer.mid(cutDataSize);
    }

    //    //!!!
    ////    memmove((void*)recivedBuffer, (void*)&recivedBuffer[cutDataSize], BUFSIZ - cutDataSize);
    //    realBufSize -= cutDataSize; // тут всегда должно уходить в ноль, если приём идёт по 1 байту!

    //    //страховка
    //    if (realBufSize >= BUFSIZ)
    //    {
    //        realBufSize = 0;
    //        expextedDataSize = 0;
    //        cutDataSize = 0;
    //    }

}
//для ПК
void slotDisconnected()
{
    QString strOut = "disconnected from " + socket->peerAddress().toString()
            + ":" + QString::number(socket->peerPort());
    std::cout << strOut.toStdString() << std::endl;

    buffer.clear();
    error = false;
    cutDataSize = 0;
    expextedDataSize = 0;
}

int main(int argc, char *argv[])
{
    QCoreApplication a(argc, argv);

    iot.readChannel = (struct RawEmbedded*)malloc(sizeof(struct RawEmbedded) * 3);

    iot.readChannel[0].dataSize = dataSizeonDataType(readType[0]);
    iot.readChannel[1].dataSize = dataSizeonDataType(readType[1]);
    iot.readChannel[2].dataSize = dataSizeonDataType(readType[2]);

    iot.readChannel[0].data = (char *)malloc(iot.readChannel[0].dataSize);
    int16_t value = 257;
    memcpy(iot.readChannel[0].data, &value, iot.readChannel[0].dataSize);

    iot.readChannel[1].data = (char *)malloc(iot.readChannel[1].dataSize);
    value = 300;
    memcpy(iot.readChannel[1].data, &value, iot.readChannel[1].dataSize);

    iot.readChannel[2].data = (char *)malloc(iot.readChannel[2].dataSize);
    value = 3;
    memcpy(iot.readChannel[2].data, &value, iot.readChannel[2].dataSize);


    socket = new QUdpSocket;
    if (!(socket->bind(QHostAddress::LocalHost, 2025, QAbstractSocket::ShareAddress)))
    {
        std::cerr << "Error bind\n";
        return -1;
    }

    QObject::connect(socket, &QUdpSocket::readyRead, slotDataRecived);

    std::cout << "Start service on 127.0.0.1:2025" << std::endl;

    return a.exec();
}
