verbkinm/IOT/IOTV/src/IOTV_HOSTS_PC/IOTV_host_id_4/main.cpp

#include <QCoreApplication>
#include <QTcpServer>
#include <QTcpSocket>

#include <iostream>

#include "creatorpkgs.h"
#include "IOTV_SH.h"
#include "iotv_server_embedded.h"

QTcpServer *server = nullptr;
QTcpSocket *socket = nullptr;

char recivedBuffer[BUFSIZ], transmitBuffer[BUFSIZ];
uint64_t realBufSize = 0;

uint64_t expextedDataSize = HEADER_SIZE;
uint64_t cutDataSize = 0;
bool error = false;


#define ADC 0
#define REPEATE 1
#define MODE 2
#define TRIGGER 3
#define ADC_BORDER 50 // граничное значение ADC для определения воспроизведения музыки

const uint8_t NUMBER_READ_CHANNEL = 4;
const uint8_t NUMBER_WRITE_CHANNEL = NUMBER_READ_CHANNEL;

const uint8_t readType[NUMBER_READ_CHANNEL] = {
                                                DATA_TYPE_INT_16,
                                                DATA_TYPE_BOOL,
                                                DATA_TYPE_INT_8,
                                                DATA_TYPE_BOOL
                                              };
struct IOTV_Server_embedded iot = {
    .id = 4,
    .name = "Cloud",
    .description = "Облачко - музыкальный ночник для Евы-Королевы",
    .numberReadChannel = NUMBER_READ_CHANNEL,
    .readChannel = NULL,
    .readChannelType = (uint8_t *)readType,
    .numberWriteChannel = NUMBER_WRITE_CHANNEL,
    .writeChannelType = (uint8_t *)readType,
    .state = 1,
    .nameSize = static_cast<uint8_t>(strlen(iot.name)),
    .descriptionSize = static_cast<uint8_t>(strlen(iot.description)),
};

QByteArray buffer;

void slotDataRecived()
{
    buffer += socket->readAll();

    qDebug() << buffer.toHex(':') << '\n';

    if ((uint64_t)buffer.size() < expextedDataSize)
        return;

    while (buffer.size() > 0)
    {
        memcpy(recivedBuffer, buffer.data(), buffer.size());

        struct Header* header = createPkgs((uint8_t*)recivedBuffer, buffer.size(), &error, &expextedDataSize, &cutDataSize);

        if (error == true)
        {
            realBufSize = 0;
            expextedDataSize = 0;
            cutDataSize = 0;
            buffer.clear();
            return;
        }

        if (expextedDataSize > 0)
            return;

        if (header->type == HEADER_TYPE_REQUEST)
        {
            if (header->assignment == HEADER_ASSIGNMENT_IDENTIFICATION)
            {
                uint64_t size = responseIdentificationData(transmitBuffer, BUFSIZ, &iot);
                socket->write(transmitBuffer, size);
            }
            else if (header->assignment == HEADER_ASSIGNMENT_READ)
            {
                uint64_t size = responseReadData(transmitBuffer, BUFSIZ, &iot, header);
                socket->write(transmitBuffer, size);
            }
            else if (header->assignment == HEADER_ASSIGNMENT_WRITE)
            {
                uint64_t size = responseWriteData(transmitBuffer, BUFSIZ, &iot, header);
                socket->write(transmitBuffer, size);
            }
            else if (header->assignment == HEADER_ASSIGNMENT_PING_PONG)
            {
                uint64_t size = responsePingData(transmitBuffer, BUFSIZ);
                socket->write(transmitBuffer, size);
            }
            else if (header->assignment == HEADER_ASSIGNMENT_STATE)
            {
                uint64_t size = responseStateData(transmitBuffer, BUFSIZ, &iot);
                socket->write(transmitBuffer, size);
            }
        }

        buffer = buffer.mid(cutDataSize);
    }

    //    //!!!
    ////    memmove((void*)recivedBuffer, (void*)&recivedBuffer[cutDataSize], BUFSIZ - cutDataSize);
    //    realBufSize -= cutDataSize; // тут всегда должно уходить в ноль, если приём идёт по 1 байту!

    //    //страховка
    //    if (realBufSize >= BUFSIZ)
    //    {
    //        realBufSize = 0;
    //        expextedDataSize = 0;
    //        cutDataSize = 0;
    //    }

}
//для ПК
void slotDisconnected()
{
    QString strOut = "disconnected from " + socket->peerAddress().toString()
            + ":" + QString::number(socket->peerPort());
    std::cout << strOut.toStdString() << std::endl;

    buffer.clear();
    error = false;
    cutDataSize = 0;
    expextedDataSize = 0;
}

//для ПК
void slotNewConnection()
{
    socket = server->nextPendingConnection();
    QString strOut = "new connection: "+ socket->peerAddress().toString() + QString::number(socket->peerPort());
    std::cout << strOut.toStdString() << std::endl;

    QObject::connect(socket, &QTcpSocket::readyRead, slotDataRecived);
    QObject::connect(socket, &QTcpSocket::disconnected, slotDisconnected);
    QObject::connect(socket, &QTcpSocket::disconnected, &QObject::deleteLater);
}

int main(int argc, char *argv[])
{
    QCoreApplication a(argc, argv);

    // Выделения памяти для iot структуры
    iot.readChannel = (struct RawEmbedded *)malloc(sizeof(struct RawEmbedded) * iot.numberReadChannel);

    for (uint8_t i = 0; i < iot.numberReadChannel; ++i)
    {
      iot.readChannel[i].dataSize = dataSizeonDataType(readType[i]);
      iot.readChannel[i].data = (char *)calloc(iot.readChannel[i].dataSize, sizeof(char));
    }

    *iot.readChannel[0].data = 121;

    server = new QTcpServer;

    QObject::connect(server, &QTcpServer::newConnection, [&](){
        slotNewConnection();
    });

    server->listen(QHostAddress("127.0.0.1"), 2027);
    std::cout << "Start service on 127.0.0.1:2027" << std::endl;

    return a.exec();
}
