verbkinm/IOT/IOTV/src/MK/FreerRTOS/id_1/main/service/relay/relay.h

/*
 * relay.h
 *
 *  Created on: 31 июл. 2024 г.
 *      Author: user
 */

#ifndef MAIN_SERVICE_RELAY_RELAY_H_
#define MAIN_SERVICE_RELAY_RELAY_H_

void relay_service_task(void *pvParameters);
const char *relay_service_task_name(void);

#endif /* MAIN_SERVICE_RELAY_RELAY_H_ */
