verbkinm/IOT/IOTV/src/IOTV_Client_QML/device.h

#pragma once

#include <QTimer>
#include <QLineSeries>

#include "base_host.h"
#include "raii_iot.h"
#include "wrap_qbytearray.h"

class Device : public Base_Host
{
    Q_OBJECT

    Q_PROPERTY(bool state READ isOnline NOTIFY signalStateChanged)
    Q_PROPERTY(int id READ getId CONSTANT)
    Q_PROPERTY(QString name READ getName CONSTANT)
    Q_PROPERTY(QString description READ getDescription CONSTANT)
    Q_PROPERTY(QString aliasName READ aliasName WRITE setAliasName NOTIFY signalAliasNameChanged)

    Q_PROPERTY(int readChannelLength READ getReadChannelLength CONSTANT)
    Q_PROPERTY(int writeChannelLength READ getWriteChannelLength CONSTANT)

    Q_PROPERTY(int logDataOverflow READ logDataOverflow CONSTANT)

public:
    Device() = default;
    explicit Device(const RAII_iot &dev, QObject *parent = nullptr);
    void update(const RAII_iot &dev);

    virtual QString getName() const override;
    virtual void setName(const QString &name) override;

    bool isOnline() const;
    void setState(bool newState);

    bool setData(uint8_t channelNumber, const QByteArray &data);
    bool addData(uint8_t channelNumber, const QByteArray &data);
    void clearData(uint8_t channelNumber);

    Q_INVOKABLE void setDataFromString(int channelNumber, QString data);
    Q_INVOKABLE QString readData(int channelNumber) const;
    Q_INVOKABLE QString readDataType(int channelNumber) const;
    Q_INVOKABLE QString writeDataType(int channelNumber) const;
    Q_INVOKABLE void setLedColorManual(uint8_t ledNumder, bool red, bool green, bool blue);
    Q_INVOKABLE void dataLogToPoints(uint8_t channelNumber, uint8_t flags);

    void setReadInterval(int interval);

    friend bool operator==(const Device &lhs, const Device &rhs);
    friend bool operator!=(const Device &lhs, const Device &rhs); // для android версий

    const QString &aliasName() const;
    void setAliasName(const QString &newAliasName);

    void addDataLog(uint8_t channelNumber, const QByteArray &data);
    void clearDataLog(uint8_t channelNumber);

    bool logDataOverflow() const;

    Q_INVOKABLE void testFunc(Wrap_QByteArray *data);

    Q_INVOKABLE static int getLOG_DATA_MAX();
    Q_INVOKABLE void fillSeries(QLineSeries *series, QList<QPointF> points);

private:
    QString _name;
    QString _aliasName;

    QTimer _timerRead, _timerState;

    std::unordered_map<uint8_t, QByteArray> _log_data_buf;

    static constexpr int LOG_DATA_MAX = 10'000'000;
    bool _logDataOverflow;

signals:
    void signalQueryIdentification();
    void signalQueryRead();
    void signalQueryState();
    void signalQueryLogData(uint64_t startInterval, uint64_t endInterval, uint32_t interval, uint8_t channelNumber, log_data_flag_t flags);
    // Посылается из клиента
    void signalResponceLogData(QList<QPointF> points, uint8_t channelNumber, uint8_t flags);

    void signalStateChanged();
    void signalUpdate();
    void signalAliasNameChanged();

    void signalDataAdded(int channel);

    // Отлавливается в producer.cpp
    void signalDataPkgComplete(int channel, QByteArray data);

    void signalTest(Wrap_QByteArray *data);

    void signalOpenReadStream(int channel);
    void signalCloseReadStream(int channel);

private slots:
    void slotTimerReadTimeOut();
    void slotTimerStateTimeOut();
};
