verbkinm/IOT/IOTV/src/MK/FreerRTOS/id_1/main/service/relay/buttons.h

/*
 * button.h
 *
 *  Created on: 31 июл. 2024 г.
 *      Author: user
 */

#ifndef MAIN_SERVICE_RELAY_BUTTONS_H_
#define MAIN_SERVICE_RELAY_BUTTONS_H_

void buttons_service_task(void *pvParameters);
const char *buttons_service_task_name(void);

#endif /* MAIN_SERVICE_RELAY_BUTTONS_H_ */
