verbkinm/IOT/IOTV/src/MK/FreerRTOS/id_1/main/Protocols/embedded/creatorpkgs.h

#ifndef CREATORPKGS_H
#define CREATORPKGS_H

#include <stdbool.h>

#include "state.h"
#include "read_write.h"
#include "identification.h"
#include "tech.h"
#include "host_broadcast.h"
#include "log_data.h"
#include "header.h"

#ifdef __cplusplus
extern "C"
{
#endif

// Формирование пакетов из сырых данных

header_t *createPkgs(uint8_t *data, uint64_t size, bool *error, uint64_t *expectedDataSize, uint64_t *cutDataSize);
header_t *createHeader(uint8_t *data, uint64_t size, bool *error, uint64_t *expectedDataSize, uint64_t *cutDataSize);
struct Identification *createIdentification(uint8_t * const data, uint64_t size, bool *error, uint64_t *expectedDataSize, uint64_t *cutDataSize);
struct State *createState(uint8_t * const data, uint64_t size, bool *error, uint64_t *expectedDataSize, uint64_t *cutDataSize);
struct Read_Write *createReadWrite(uint8_t * const data, uint64_t size, bool *error, uint64_t *expectedDataSize, uint64_t *cutDataSize);
struct Tech* createTech (uint8_t *data, uint64_t size, bool *error, uint64_t *expectedDataSize, uint64_t *cutDataSize);
struct Log_Data *createLogData(uint8_t * const data, uint64_t size, bool *error, uint64_t *expectedDataSize, uint64_t *cutDataSize);
struct Host_Broadcast *createHostBroadCast(uint8_t * const data, uint64_t size, bool *error, uint64_t *expectedDataSize, uint64_t *cutDataSize);

// Проверка для header c заданным assigment, должно ли быть тело пакета
bool isBodyMustBe(uint8_t type, uint8_t assigment);

bool isLittleEndian();
void dataReverse(void *data, uint64_t size);

#ifdef __cplusplus
}
#endif


#endif // CREATORPKGS_H
