verbkinm/IOT/IOTV/src/MK/FreerRTOS/id_1/main/Protocols/embedded/iotv_types.h

#ifndef IOTV_TYPES_H
#define IOTV_TYPES_H

#define RETURN_WARNING fprintf(stderr, "%s %s %d: return warning!\n", __FILE__, __func__, __LINE__); fflush(stderr);

#define HEADER_SIZE 24
#define IDENTIFICATION_SIZE  16
#define STATE_SIZE  15
#define READ_WRITE_SIZE 15
#define TECH_SIZE 15
#define HOST_BROADCAST_SIZE 16
#define LOG_DATA_SIZE 35

typedef enum {
    HEADER_TYPE_NONE = 0,
    HEADER_TYPE_REQUEST,
    HEADER_TYPE_RESPONSE
} header_type_t;

typedef enum
{
    HEADER_ASSIGNMENT_NONE = 0,
    HEADER_ASSIGNMENT_IDENTIFICATION,
    HEADER_ASSIGNMENT_STATE,
    HEADER_ASSIGNMENT_READ,
    HEADER_ASSIGNMENT_WRITE,
    HEADER_ASSIGNMENT_PING_PONG,
    HEADER_ASSIGNMENT_TECH,
    HEADER_ASSIGNMENT_HOST_BROADCAST,
    HEADER_ASSIGNMENT_LOG_DATA
} header_assignment_t;

typedef enum
{
    HEADER_FLAGS_NONE = 0,
    HEADER_FLAGS_ERROR = 0xFF
} header_flag_t;

typedef enum
{
    Identification_FLAGS_NONE = 0x00,
    Identification_FLAGS_DELETE = 0x01,
    Identification_FLAGS_AUTONOMIC_DEVICE = 0x02,
    Identification_FLAGS_ERROR = 0xFF
} identification_flag_t;

typedef enum
{
    ReadWrite_FLAGS_NONE = 0,
    ReadWrite_FLAGS_IGNORE_CH = 0x01,
    ReadWrite_FLAGS_OPEN_STREAM = 0x02,
    ReadWrite_FLAGS_CLOSE_STREAM = 0x03,
    ReadWrite_FLAGS_WRITE_OK = 0x04,
    ReadWrite_FLAGS_WRITE_ERR = 0x05,
    ReadWrite_FLAGS_ERROR = 0xFF
} readwrite_flag_t;

typedef enum
{
    STATE_FLAGS_NONE = 0,
    STATE_FLAGS_ERROR = 0xFF
} state_flag_t;

typedef enum
{
    State_STATE_OFFLINE = 0,
    State_STATE_ONLINE
} state_t;

typedef enum
{
    Tech_TYPE_NONE = 0,
    Tech_TYPE_EV_AC = 0x01,
    Tech_TYPE_UPDATE = 0x02,
    Tech_TYPE_RUN_EVENT = 0x03,
    Tech_TYPE_RUN_ACTION = 0x04,
} tech_type_t;

typedef enum
{
    Tech_FLAGS_NONE = 0,
    Tech_FLAGS_ERROR = 0xFF
} tech_flag_t;

typedef enum
{
    Host_Broadcast_FLAGS_NONE = 0,
    Host_Broadcast_FLAGS_TCP_CONN = 1,
    Host_Broadcast_FLAGS_UDP_CONN = 2,
    Host_Broadcast_FLAGS_ERROR = 0xFF
} host_broadcast_flag_t;

typedef enum
{
    LOG_DATA_RW = 0,
    LOG_DATA_R,
    LOG_DATA_W
} log_data_flag_t;

#endif // IOTV_TYPES_H
