verbkinm/IOT/IOTV/src/IOTV_HOSTS_PC/TCP/IOTV_host_camera/widget.h

#ifndef WIDGET_H
#define WIDGET_H

#include "qaudioinput.h"
#include "qaudiosource.h"
#include "qmediaplayer.h"
#include "qmediarecorder.h"
#include <QMediaDevices>
#include <QCameraDevice>
#include <QCamera>
#include <QImageCapture>
#include <QMediaCaptureSession>
#include <QMediaFormat>
#include <QTimer>
#include <QAudioDecoder>
#include <QAudioOutput>
#include <QAudioSink>
#include <QFile>
#include <QThread>
class Widget : public QObject
{
    Q_OBJECT

public:
    Widget(QObject *parent = nullptr);
    ~Widget();

    const QImage getImage() const;
    size_t getImageSavedSize() const;

    void start();
    void stop();

private:
    QCamera *camera;
    QMediaCaptureSession captureSession;
    QImageCapture imageCapture;
    QTimer *timer, _timerAudio;
    QImage _image;


    QMediaRecorder *recorder;
    QMediaCaptureSession session;

    QAudioInput *audioIn;
    QAudioSource *source;
    QIODevice *devIn;

    QIODevice *devOut;
    QAudioOutput *_audioOut;
    QAudioSink *_audioSink;

    static constexpr int INTERVAL = 25;

    bool timerActive;

public slots:
    void processCapturedImage(int requestId, const QImage &img);
    void processCapturedFrame(int requestId, const QVideoFrame &frame);
    void timerOut();
    void errorCapture(int, QImageCapture::Error err, QString errorStr);
    void readyForCapture(bool);


    void displayErrorMessage();

    void slotReadyRead();
    void slotAudio();

signals:
    void signalFirstCapture();
    void signalImageCaptured();

    void signalAudio(QByteArray data);
};
#endif // WIDGET_H
