verbkinm/IOT/IOTV/src/MK/FreerRTOS/id_1/main/Protocols/embedded/identification.h

#ifndef IDENTIFICATION_H
#define IDENTIFICATION_H

#include <stdint.h>

#ifdef __cplusplus
extern "C"
{
#endif

struct Identification
{
    uint16_t id;
    uint16_t descriptionSize;
    uint8_t nameSize;

    uint8_t numberWriteChannel;
    uint8_t numberReadChannel;
    uint8_t flags;

    char *name;
    char *description;

    uint8_t *writeChannelType;
    uint8_t *readChannelType;
};
typedef struct Identification identification_t;

uint64_t identificationCheckSum(const identification_t *body);
uint64_t identificationSize(const identification_t *body);
uint64_t identificationToData(const identification_t *body, char *outData, uint64_t outDataSize);
void clearIdentification(identification_t *ident);

identification_t *identificationCopy(const identification_t *ident);

#ifdef __cplusplus
}
#endif

#endif // IDENTIFICATION_H
