verbkinm/IOT/IOTV/src/MK/FreerRTOS/Factory_IOTV/main/global_extern.c

/*
 * global_extern.c
 *
 *  Created on: 27 сент. 2023 г.
 *      Author: user
 */

#include "global_def.h"
#include "stdbool.h"

iotv_wifi_status_t global_wifi_sta_status = IOTV_WIFI_STA_NULL;
//bool global_wifi_sta_connect = false;
