verbkinm/IOT/IOTV/src/MK/FreerRTOS/id_1 - Switch/ESP32/iotv/main/LedSignals.c

/*
 * errorBlink.c
 *
 *  Created on: 18 апр. 2023 г.
 *      Author: user
 */

#include "LedSignals.h"

extern QueueHandle_t xQueueLedSignals;
static const char *TAG = "LedSignals";
static const char *failStr[] = {
		"I2C_INIT_FAIL",
		"I2C_DEINIT_FAIL",
		"I2C_WRITE_FAIL",
		"I2C_READ_FAIL",
		"RESULT__INTERRUPT_STATUS_GPIO_LOOP",
		"RESULT__RANGE_STATUS_LOOP",
		"SYSTEM__FRESH_OUT_OF_RESET_LOOP"
};

static SemaphoreHandle_t xSemaphore = NULL;

static void errorLoopBlink(const char* errorTag, uint8_t value);

void LedSignals_Task(void *pvParameters)
{
	ESP_LOGW("LedSignals", "LedSignals task created");

	xSemaphore = xSemaphoreCreateMutex();
	struct LedSignalPkg pkg = {NULL, 0};

	while (true)
	{
		xQueueReceive(xQueueLedSignals, (void *)&pkg, portMAX_DELAY);
		errorLoopBlink(pkg.TAG, pkg.errorNumber);
	}
}

static void errorLoopBlink(const char* errorTag, uint8_t value)
{
	if (xSemaphoreTake(xSemaphore, portMAX_DELAY) == pdTRUE)
	{
		gpio_set_direction(LED_ERROR, GPIO_MODE_INPUT_OUTPUT);

		for (uint8_t counter = 0; counter < value; ++counter)
		{
			gpio_set_level(LED_ERROR, 1);
			vTaskDelay(100 / portTICK_PERIOD_MS);
			gpio_set_level(LED_ERROR, 0);
			vTaskDelay(100 / portTICK_PERIOD_MS);
		}
		vTaskDelay(500 / portTICK_PERIOD_MS);

		if ((value > 0) && (value < SYSTEM__FRESH_OUT_OF_RESET_LOOP)) // SYSTEM__FRESH_OUT_OF_RESET_LOOP - крайний элемент
			ESP_LOGE(TAG, "%s FAIL: %s", errorTag, failStr[value - 1]);

		xSemaphoreGive( xSemaphore );
	}
}

//void ledSignal(gpio_num_t gpio, bool state)
//{
//	gpio_set_direction(gpio, GPIO_MODE_OUTPUT);
//	gpio_set_level(gpio, state);
//}
