verbkinm/IOT/(commit log)

2021-04-24 Исправлен протокол IOTV_SH
2021-05-15 протокол IOTV_SC
2021-06-17 Промежуточный коммит
2021-06-30 бета версия без сохранения настроек
2021-07-01 Revert "Merge branch 'main' into Switcher"
    This reverts commit 1a2e9f53b36e01c654dad687eccd6eb3e05247fe.
2021-07-01 В списке удаления серверов убрано "scrollAreaWidgetContents"
2021-07-01 Реализация удаления устройств с Tab_Room
2021-07-02 На вкладках комнат, устройства не пропадают при отключении или удалении сервера
2021-07-03 Сохранение настроек для серверов и вкладок комнат. Разница рамок в линукс и виндовс
2021-10-14 WAY таймер
2021-10-14 Com arduino защита от переполнения. Добавлен таймер для повторной отправки пакетов write на хост устройства
2021-10-20 не работает writeTimer
2021-10-20 Создание типа соединения File_conn_type
2021-10-20 File_conn_type
    Открывает и читает с файла. Доделать запись в файл
2021-10-21 Добавлен класс GUI_Full.
2021-10-22 SERVER
    RAW.str, чтение и запись. устранение ошибок работы с динамической памятью
2021-10-22 GUI_Full_Text
    отправка киррилицы
2021-10-27 разработка accumPacket
    Для IOTV_SC протокола
2021-10-28 MK
    Ардуино BME280
2021-11-16 QML client
    Начало разработки
2021-11-18 qml host
    Отображение хостов, их информации и состояния подключения. Удаление после отключения от сервера
2021-12-01 Виртуальное устройство bme280
2022-03-01 Удаление методов повторной отправки
    При чтении и записи. Новый протокол IOTV_SH::PING
2022-03-17 Fix
    Исправлен баг получения данных в один буфер для всех IOT_HOST
    [wrapper.h]
2022-03-22 Исправление протокола IOTV_SH
2022-04-06 Начало создания типа соединения UDP
2022-08-01 IOT_Host
    Каждый в своём потоке
2022-08-05 накопление буфера приёма данных
2022-08-15 IOTV_host_bme280
    Имитация устройства bme280
2022-08-16 IOTV_host_bme280
    Избавляемся от зависимостей Qt и stl
2022-08-18 IOTV_host_switch
    Добавлен проект имитации устройства switch
2022-08-18 Клиент - сервер.
    Разработка кода по взаимодействию клиента и сервера.
2022-08-20 Client
    приём запросов сервером от клиента
2022-08-22 class Client
    Завершен
2022-09-05 QML Device page
2022-09-06 qml
    Device 0
2022-09-06 MK
    Arduino data type fix
    [main.cpp]
2022-09-06 Очистка мусора
2022-09-06 qml client
    ошибка в отправке данных на стороне клиента и хоста
2022-09-07 conn type File error
    [main.cpp]
2022-09-19 Кириллица
    IOTV_Hosts.ini - имя хоста и описание
2022-09-19 дублирование имен хостов
2022-10-04 Смена иконок приложения
2022-10-26 fix
    Отказ от библиотек
    Switch - время отзыва
    [IOTV_SH.h]
2022-11-14 id - 4
    Добавлены картинки для кнопок
2022-11-24 QML_Client - перенос settings в qml
2022-11-25 Device Settings
2023-01-17 IOTVP
    Разработка протокола
2023-01-27 Собирается с новым протоколом для SH
2023-01-30 IOTVP завершен
2023-01-30 ID 1
    ESP-01_2 под IOTVP_embedded
2023-02-06 Client_QML
    fix update from id 0
    [client.cpp, client.h, device.cpp, device.h]
2023-02-10 Очередное ревью
2023-02-12 timer state
2023-02-13 IOTV_tools
    конвертер - ok
2023-02-14 IOTV_Client
    device[name].update()
2023-02-17 IOTV_Client
    review. Много loader стало и мало js
2023-02-19 Много чего =)
2023-03-05 Исправлен баг с потоками для хостов и клиентов
    [main.cpp]
2023-03-21 id-1 ESP32
2023-04-14 iotvp - переписано на Си.
    Добавлен id-1 для esp32 на freeRTOS
2023-04-21 Документация
2023-05-16 IOTV_server 0.6
    Добавлена поддержка UDP
2023-05-19 Events
    Начало разработки событий
2023-05-20 Raw
    Добавление операторов сравнения и арифметический операторов. Добавление тестов по этой части
2023-05-22 pcb id4
    [id4.kicad_pcb]
2023-05-23 Расширение протокола
2023-05-23 доработка протокола
    У Header убраны указатели данных, оставлен один - void *
2023-05-26 pcd id5
    [IOTV-B_Cu.gbl, IOTV-B_Mask.gbs, IOTV-B_Paste.gbp, IOTV-B_Silkscreen.gbo, IOTV-Edge_Cuts.gm1, IOTV-F_Cu.gtl, IOTV-F_Mask.gts, IOTV-F_Paste.gtp]
2023-05-29 Список событий и действий в json формат
2023-05-29 id-5 pcb
    [IOTV.kicad_pcb, IOTV.kicad_sch]
2023-05-31 активити с созданием нового события
2023-06-01 протокол, добавлен тип tech
    передача json event action от сервера к клиенту
2023-06-10 cad корпус id5
    [IOTV.kicad_pcb, id5.FCStd]
2023-06-12 cad id5
    [id5.FCStd]
2023-06-22 pcb src id4
    [id4.kicad_pcb, id4.kicad_sch, untitled.kicad_sch]
2023-07-07 id4
    pcd docs MK
    [id4.kicad_sch, untitled.kicad_sch]
2023-07-10 iotv server
    проверка существования IOTV_Event_Action.json файла и его создание при отсутствии
2023-07-10 iotv client
    spacing для создания событий
2023-07-12 EVENT ACTION JSOn
    Запись и удаление событий с клиента
2023-07-16 много всего для iotv client
2023-07-23 ITOV id4, iotv server
    [nvs.csv]
2023-07-26 PCB - ID4
    [id4.kicad_pcb, id4.kicad_sch, leds.kicad_sch]
2023-07-27 id4 cad
    [id4-B_Cu.gbl, id4-B_Mask.gbs, id4-B_Paste.gbp, id4-B_Silkscreen.gbo, id4-Edge_Cuts.gm1, id4-F_Cu.gtl, id4-F_Mask.gts, id4-F_Paste.gtp]
2023-07-28 cad id4
2023-07-31 id4 pcd cad
    [DFR0299--3DModel-STEP-56544.STEP, DFR0299.step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]
2023-08-01 cad id4.1
    [id4.1.FCStd]
2023-08-01 IOTV_Server при запуске с параметрами по умолчанию грузит CPU
2023-08-02 pcb id4 - rezonit OK
    [id4-B_Cu.gbl, id4-B_Mask.gbs, id4-B_Paste.gbp, id4-B_Silkscreen.gbo, id4-Edge_Cuts.gm1, id4-F_Cu.gtl, id4-F_Mask.gts, id4-F_Paste.gtp]
2023-08-02 cad id4 рисунки на кнопках
    [id4.1.FCStd]
2023-08-03 review server + восстановление тестов
2023-08-03 Тесты восстановлены
2023-08-05 pcb id5 маркировки номиналов резисторов
    [IOTV.kicad_sch]
2023-08-10 pcd id 4
    на кнопках исправлен контакт с 5в на 3,3в
    [id4.kicad_pcb, id4.kicad_sch, leds.kicad_sch]
2023-08-11 MK ID5 ver 1.1
    [id4-B_Cu.gbl, id4-B_Mask.gbs, id4-B_Paste.gbp, id4-B_Silkscreen.gbo, id4-Edge_Cuts.gm1, id4-F_Cu.gtl, id4-F_Mask.gts, id4-F_Paste.gtp]
2023-08-14 PCB id5
    [IOTV.kicad_pcb, IOTV.kicad_sch]
2023-08-14 pcb id5 rev1.2
    [IOTV.kicad_pcb, IOTV.kicad_sch]
2023-08-15 pcb id5 rev 1.2
    [IOTV-B_Cu.gbl, IOTV-B_Mask.gbs, IOTV-B_Paste.gbp, IOTV-B_Silkscreen.gbo, IOTV-Edge_Cuts.gm1, IOTV-F_Cu.gtl, IOTV-F_Mask.gts, IOTV-F_Paste.gtp]
2023-08-15 pcb id5 rev 1.1 and rev 1.2
    [IOTV-B_Cu.gbl, IOTV-B_Mask.gbs, IOTV-B_Paste.gbp, IOTV-B_Silkscreen.gbo, IOTV-Edge_Cuts.gm1, IOTV-F_Cu.gtl, IOTV-F_Mask.gts, IOTV-F_Paste.gtp]
2023-08-31 pcb id5 rev 1.2 ssr
    [IOTV.kicad_pcb]
2023-09-14 MK id5 1.1
    [IOTV.kicad_pcb, IOTV.kicad_sch]
2023-09-18 id5 время и дата выравнивание по центру
2023-09-28 Прошивка по умолчанию.
    [nvs.csv, partitions.csv]
2023-09-29 IOTV Factory - ok
    [nvs.csv, partitions.csv]
2023-10-02 PCB id4 кнопки на землю
    [id4-B_Cu.gbl, id4-B_Mask.gbs, id4-B_Paste.gbp, id4-B_Silkscreen.gbo, id4-Edge_Cuts.gm1, id4-F_Cu.gtl, id4-F_Mask.gts, id4-F_Paste.gtp]
2023-10-06 ID 7 описание
2023-10-13 передача потоковых данных
2023-10-16 потоки чтения и записи
    [IOTV.kicad_sch]
2023-10-16 потоки
2023-10-16 изменение протокола. Разработка версии 3
2023-10-17 передача фрагментами
2023-10-18 передача фрагментов до клиента
2023-11-13 Wrap_QByteArray
    передача qbytearray C++ -> qml -> C++
2023-12-13 rgb panel
    wifi autoconnect
    [partitions.csv]
2023-12-22 rgb panel
    Основное окно - шаблон данных
2023-12-26 rgb panel
    настройки дисплея - ok
2023-12-26 rgb panel
    Русская раскладка клавиатуры
2023-12-27 rgb panel
    дневной/ночной режимы яркости дисплея
2023-12-27 rgb panel
    Сообщение при ошибки SD карты
2023-12-28 rgb panel
    Установка времени/даты вручную. Погода за неделю.
2023-12-29 rgb panel
    утечка памяти для service weather исправлена
2024-01-16 rgb panel
    График погоды - ok
2024-01-17 rgb panel
    удалены extern для переменных-регистров статусов и ошибок
2024-01-19 id8 esp32-cam
    [nvs.csv]
2024-01-19 IOTV server
    _counterPing и _counterState убрано с лишних мест
2024-01-22 IOTV client
    id 8 - звук отстаёт!
2024-01-29 home_meteo_II
    Оповещение о новых обновлениях
2024-01-30 home_meteo_II
    Заставка запуска
    [partitions.csv]
2024-02-09 home_meteo_II 0.3.0 настройка для калибровки bme280
2024-02-09 home_meteo_II 0.3.1 DS3231 синхронизация при запуске
2024-02-14 home_meteo_II 0.3.2
    калибровка датчика bme280 по 0,1%.
    на главном экране у каждого блока своя частота обновления информации.
    в настройках датчиков экран gui не тормозит из-за ошибок считывания bme280
2024-02-16 home_meteo_II 0.4.0
    Добавлена страница "Погода в доме" с локальными показаниями температуры, влажности и давления
2024-02-19 home_meteo_II 0.4.1
    Поворот дисплея до стартовой заставки.
2024-02-21 Сервер и клиент - 0.9
2024-03-03 id_8 автообновление
    [nvs.csv, partitions.csv]
2024-03-07 MK id5 2.0.1
    [nvs.csv, partitions.csv]
2024-03-13 (no branch):
    MK id5 2.3.1
    [partitions.csv]
2024-03-13 MK id5 2.3.1
    [partitions.csv]
2024-03-19 IOTV_Client изменение архитектуры
2024-03-22 IOTV_host_camera_udp
    Через broadcast указывается хосты как tcp так и udp
2024-03-22 IOTV_Client
    графическое представление событий
2024-03-25 IOTV_Client 0.13
    Изменены в событиях кнопки сохранить, удалить, настроить (будильник, таймер)
2024-03-26 удаление старых файлов
    [IOTV.kicad_pcb]
2024-03-26 удаление лишних файлов
    [partitions.csv]
2024-03-28 Протокол - добавление типа Log_Data
2024-03-29 IOTV протокол - доработан запрос логов
2024-03-30 IOTV_Client Log_Data нулевой завершающий пакет
2024-04-04 chartView проверка на тип данных. Отображение bool типа как 0 или 1
2024-04-05 Передача лог данных пакетами
2024-04-05 уменьшение точек на графике лога по оси X за счет округления до 0,001
2024-04-05 уменьшение точек на графике лога по оси X
    за счет отбрасывания промежуточных повторяющихся значений на осиY
    11122333456 -> 112233456
2024-04-09 Ускорение отрисовки графика логов!
2024-04-09 log chart легенда
2024-04-10 log chart id2
    Масштабирование и перемещение
2024-04-11 IOTV_server
    log_data парсинг лог файла в разных потоках для каждого запроса.
2024-04-12 полная херня с потоками!
2024-04-12 потоки - deleteLater
2024-04-13 streamread исправлена ошибка взаимодействия между потоками
    [main.cpp]
2024-04-15 MK id5
    Удалена работа с ds3231
2024-04-15 Log_chart - интервалы для каналов
2024-04-16 0.17
    масштабирования по осям. Запросы данных только для отображаемых lineSeries
2024-04-30 логи по хостам записываются отдельно для каждого канала
2024-05-08 MK id_2
    [nvs.csv, partitions.csv]
2024-05-16 Документация устройств - ID9
2024-05-17 документация dht22
2024-05-17 документация ID9
2024-05-22 extern C для кода протокола IOTVP
2024-05-29 iotv_server 0.16
    имя iotv_host устанавливается из пакета identification поля name. Одинаковые имена исключаются. К имени добавляется номер, если оно повторяется.
2024-06-07 Переработка json событий
2024-06-14 iotv_client убрал alias имена устройств
2024-06-20 iotv_сервер на cmake телеграм бот
2024-06-20 команды бота
2024-06-26 удаление pcb
    удаление pcb
    [DFR0299--3DModel-STEP-56544.STEP, DFR0299.step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]
2024-07-20 iotv_client
    запуск action с клиента
2024-07-20 iotv_client и iotv_server
    запуск действия с клиента
2024-07-22 iotv_server 0.22 iotv_client 0.24
    Запуск событий и действий с клиента
2024-07-22 iotv_client 0.25
    BUFSIZE установлен в 8192 в client.cpp. На arm по умолчанию он был равен 1024, из-за чего не отрабатывал правильно протокол iotv
2024-07-23 iotvp, iotv_server 0.23, iotv_client 0.26
    Все response функции используют указатель на функцию записи данных
    Только responseState остался без возможности фрагментации данных
2024-07-23 iotvp
    добавлен RETURN_WARNING
    исправлен todo.txt
2024-07-24 iotvp, iotv_server 0.23, iotv_client 0.26
    Фрагментация пакета идентификации. Сборка фрагментов в один пакет при приёме.
2024-07-24 Сборщик пакетных фрагментов
2024-07-25 MK id_5 2.4.3 обновление протокола
2024-07-26 iotv_server
    Вывод информации о хостах в файл в режиме реального времени.
2024-07-26 MK id5
    [partitions.csv]
2024-07-27 iotv_server
    вывод данных о хостах в файлы
2024-07-31 MK id-1
    [nvs.csv, partitions.csv]
2024-08-02 MK Factory_IOTV
    [nvs.csv, partitions.csv]
2024-08-09 file:///home/user/eclipse-workspace/Factory_IOTV/main file:///home/user/eclipse-workspace/Factory_IOTV/CMakeLists.txt file:///home/user/eclipse-workspace/Factory_IOTV/nvs.csv file:///home/user/eclips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
    [partitions.csv]
